trappitsch/cryostorage/cryostorage_controller_2025-09-05.png

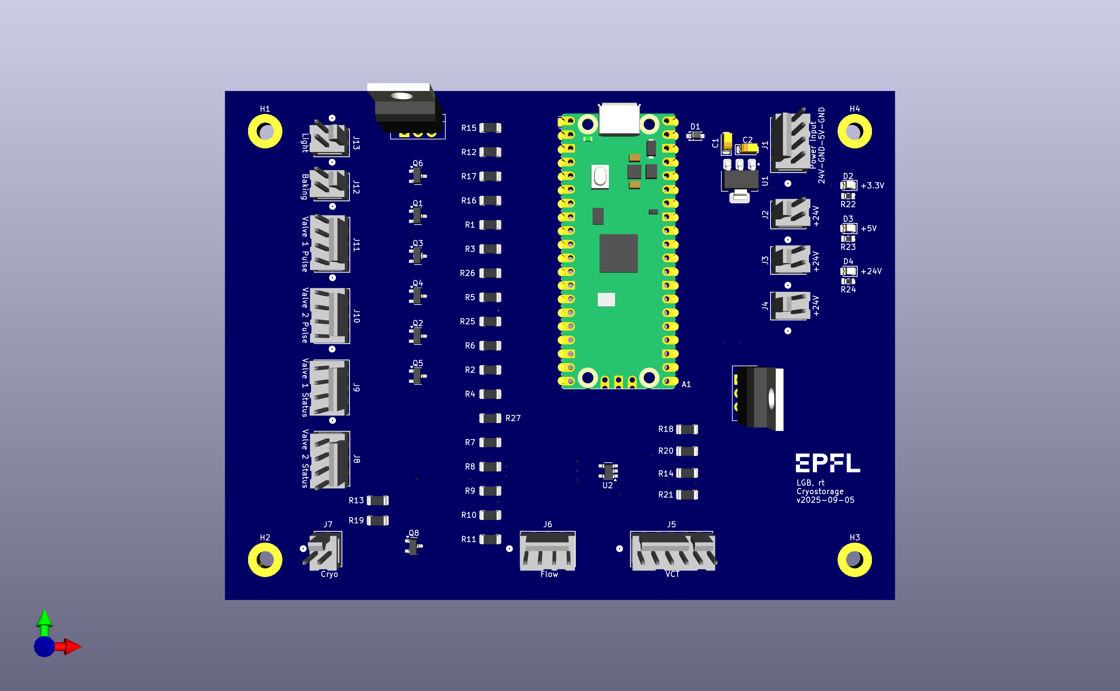
cryostorage_controller_2025-09-05.png
