trappitsch/cryostorage/cryostorage_pcb_2025-09-12.png

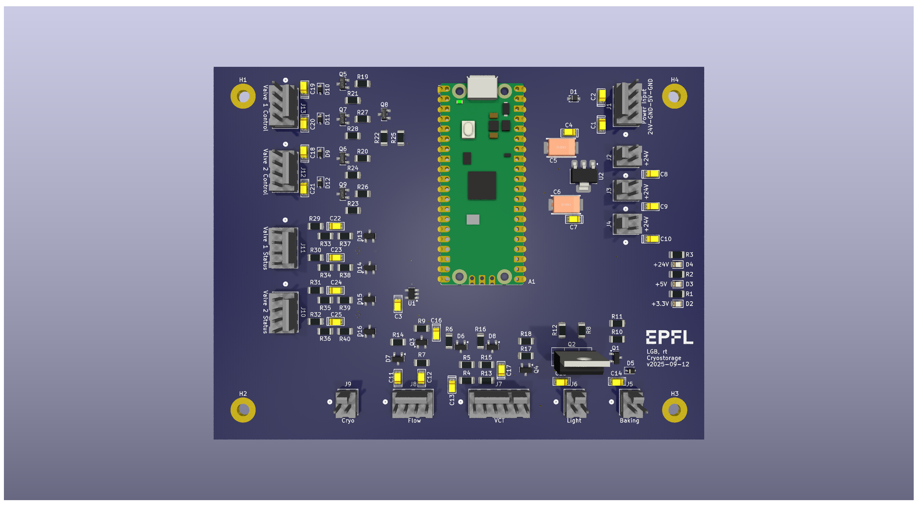
cryostorage_pcb_2025-09-12.png
