trappitsch/cryostorage/controller/pfeiffer_omnicontrol/README.md

# Pfeiffer - Omnicontrol

Instrument driver for the Pfeiffer Omnicontrol.

To run the examples, you can use the following command:

```bash
cargo run --example $NAME
``` 

Here, `$NAME` should be replaced with the name of the example you want to run.
