trappitsch/cryostorage/pcb_controller/.kinotes/cryostorage_controller_v1_worklog_20260212.md

# Work Log — cryostorage_controller_v1
**Total: 0h 0m**
