trappitsch/cryostorage/wiring_schematic_2025-08-26.pdf

A | A
B | B

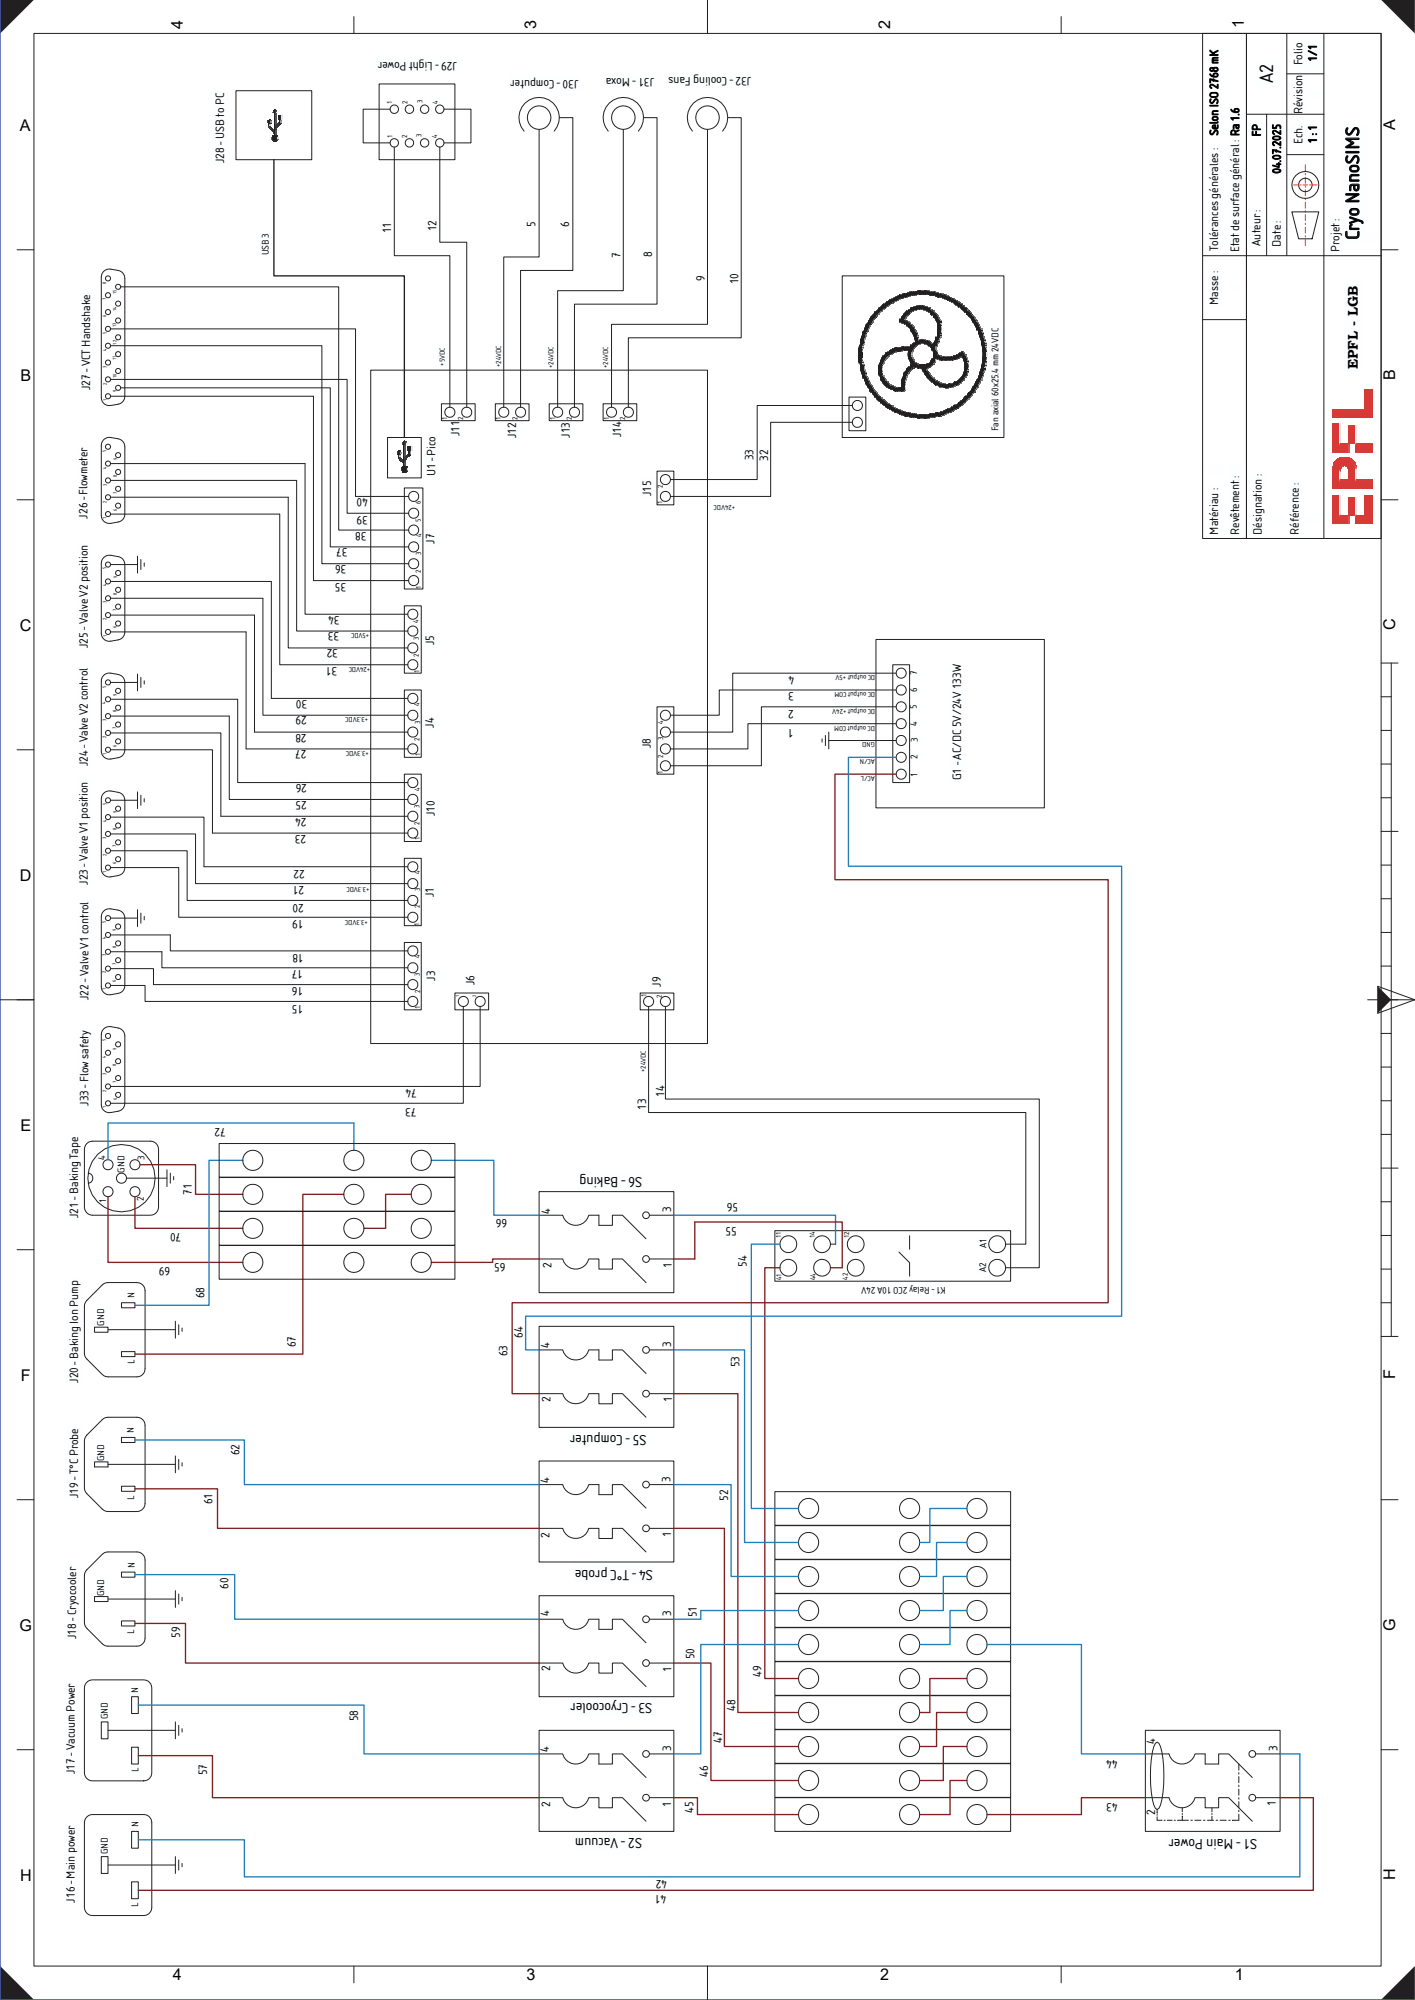
[picture p3: page 1]

Etat de surface général :

J22 - Valve V1 control J23 - Valve V1 position J25 - Valve V2 position J24 - Valve V2 control J26 - Flowmeter

J16 - Main power J17 - Vacuum Power J18 - Cryocooler J19 - T°C Probe J20 - Baking Ion Pump J21 - Baking Tape

GND GND GND GND GND
