trappitsch/cryostorage/cryostorage_schematic_2026-07-10.pdf

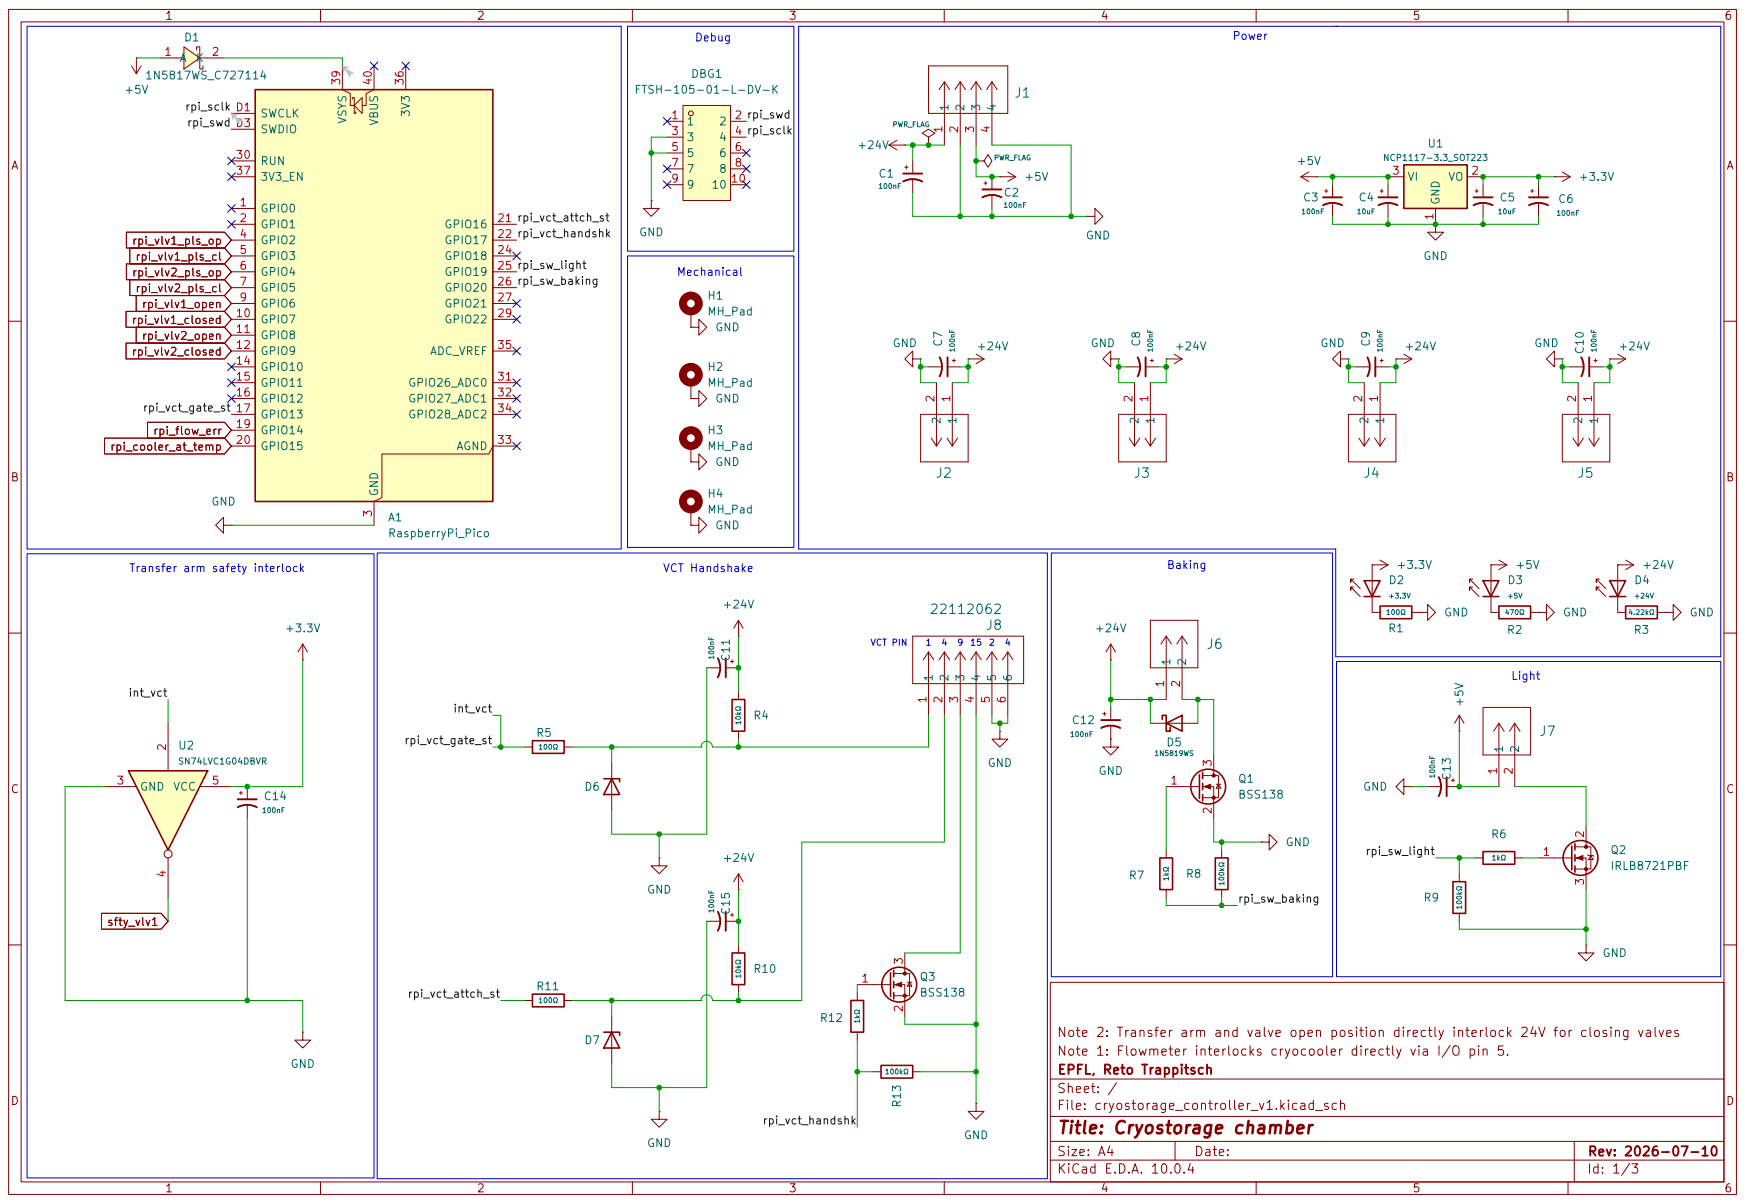
[picture p4: page 1]

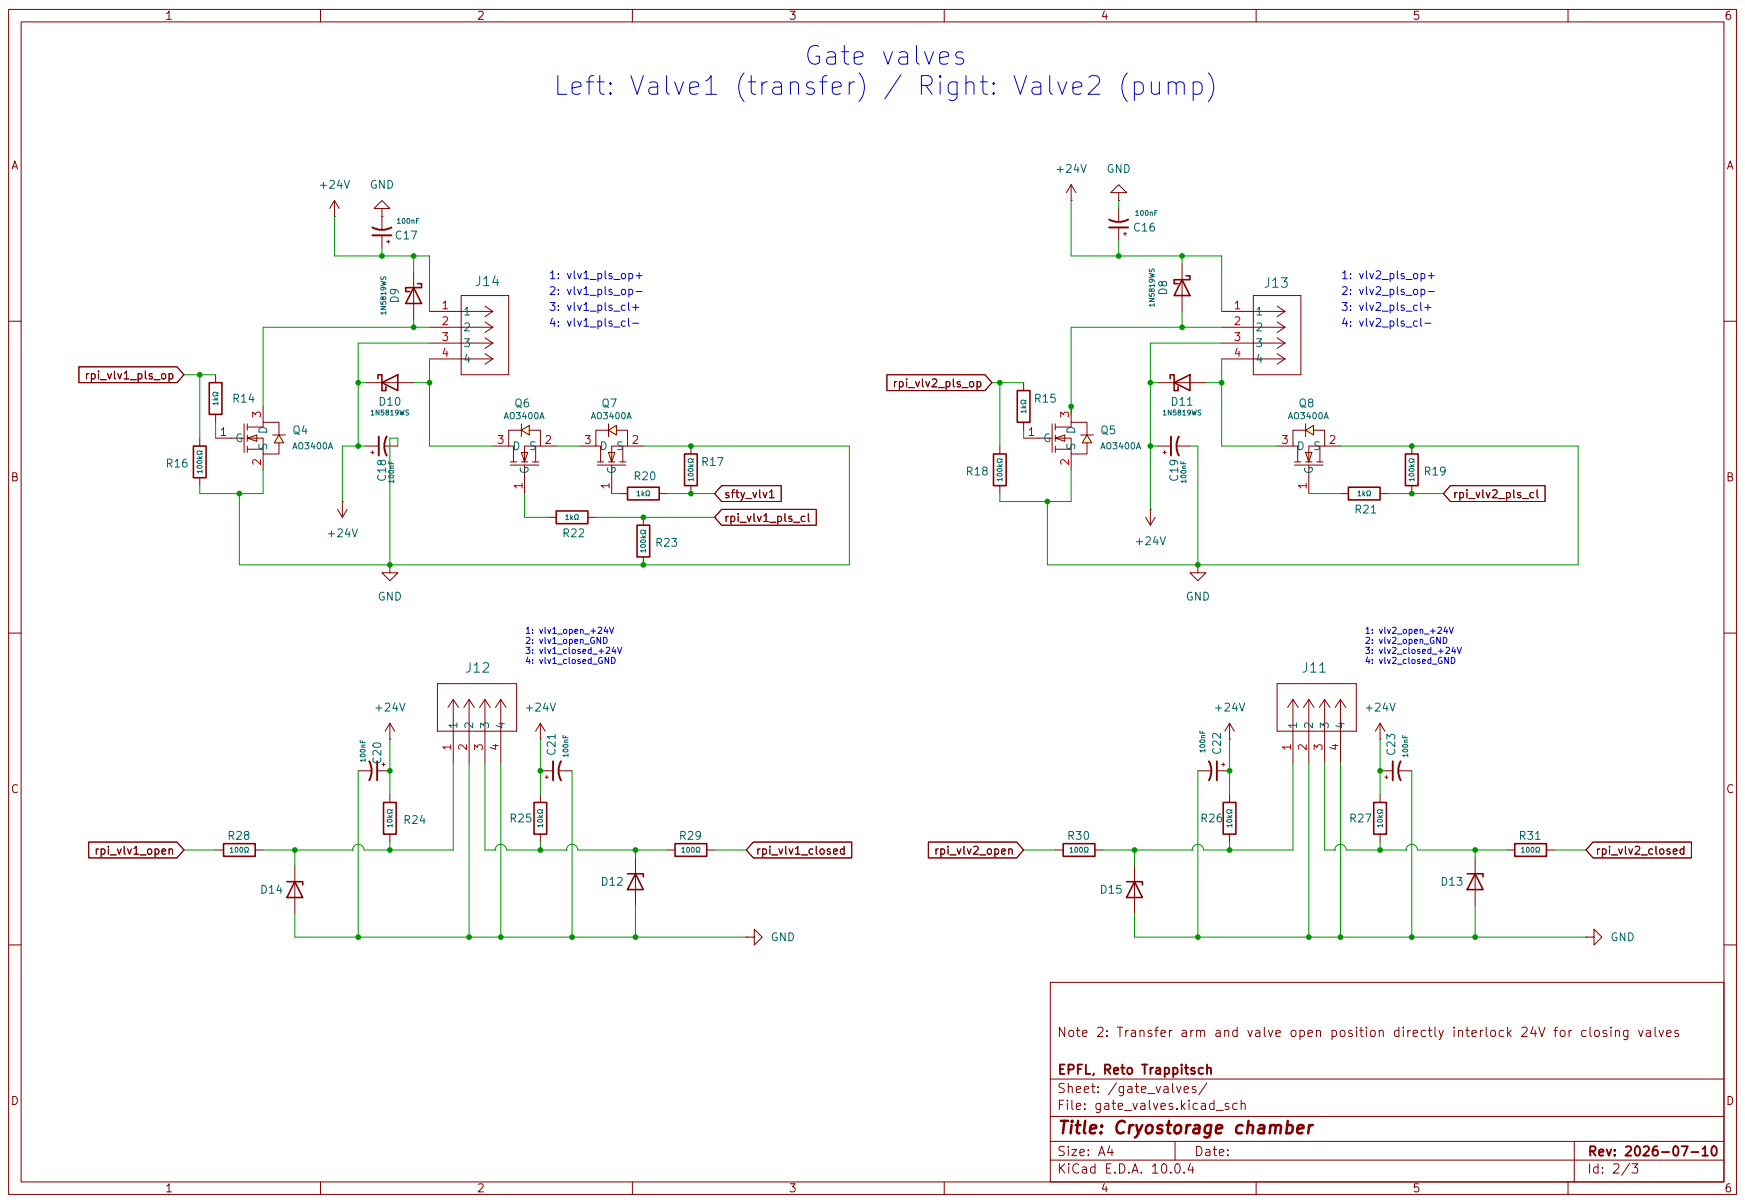
[picture p5: page 2]

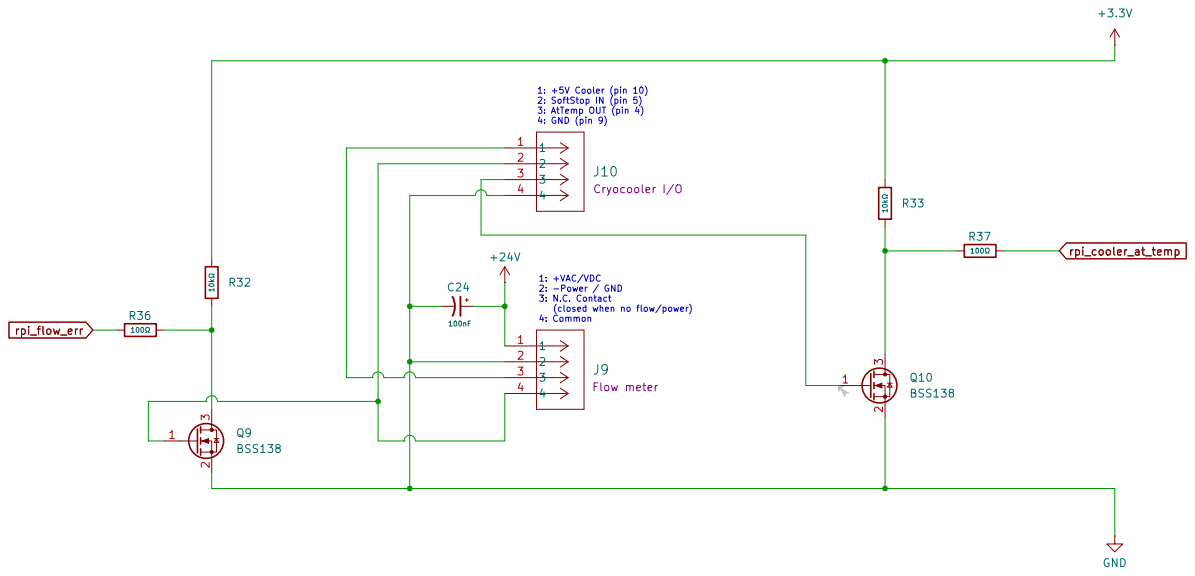
[picture p6: page 3]
