trappitsch/cryostorage/cryostorage_schematic_2026-02-13.pdf

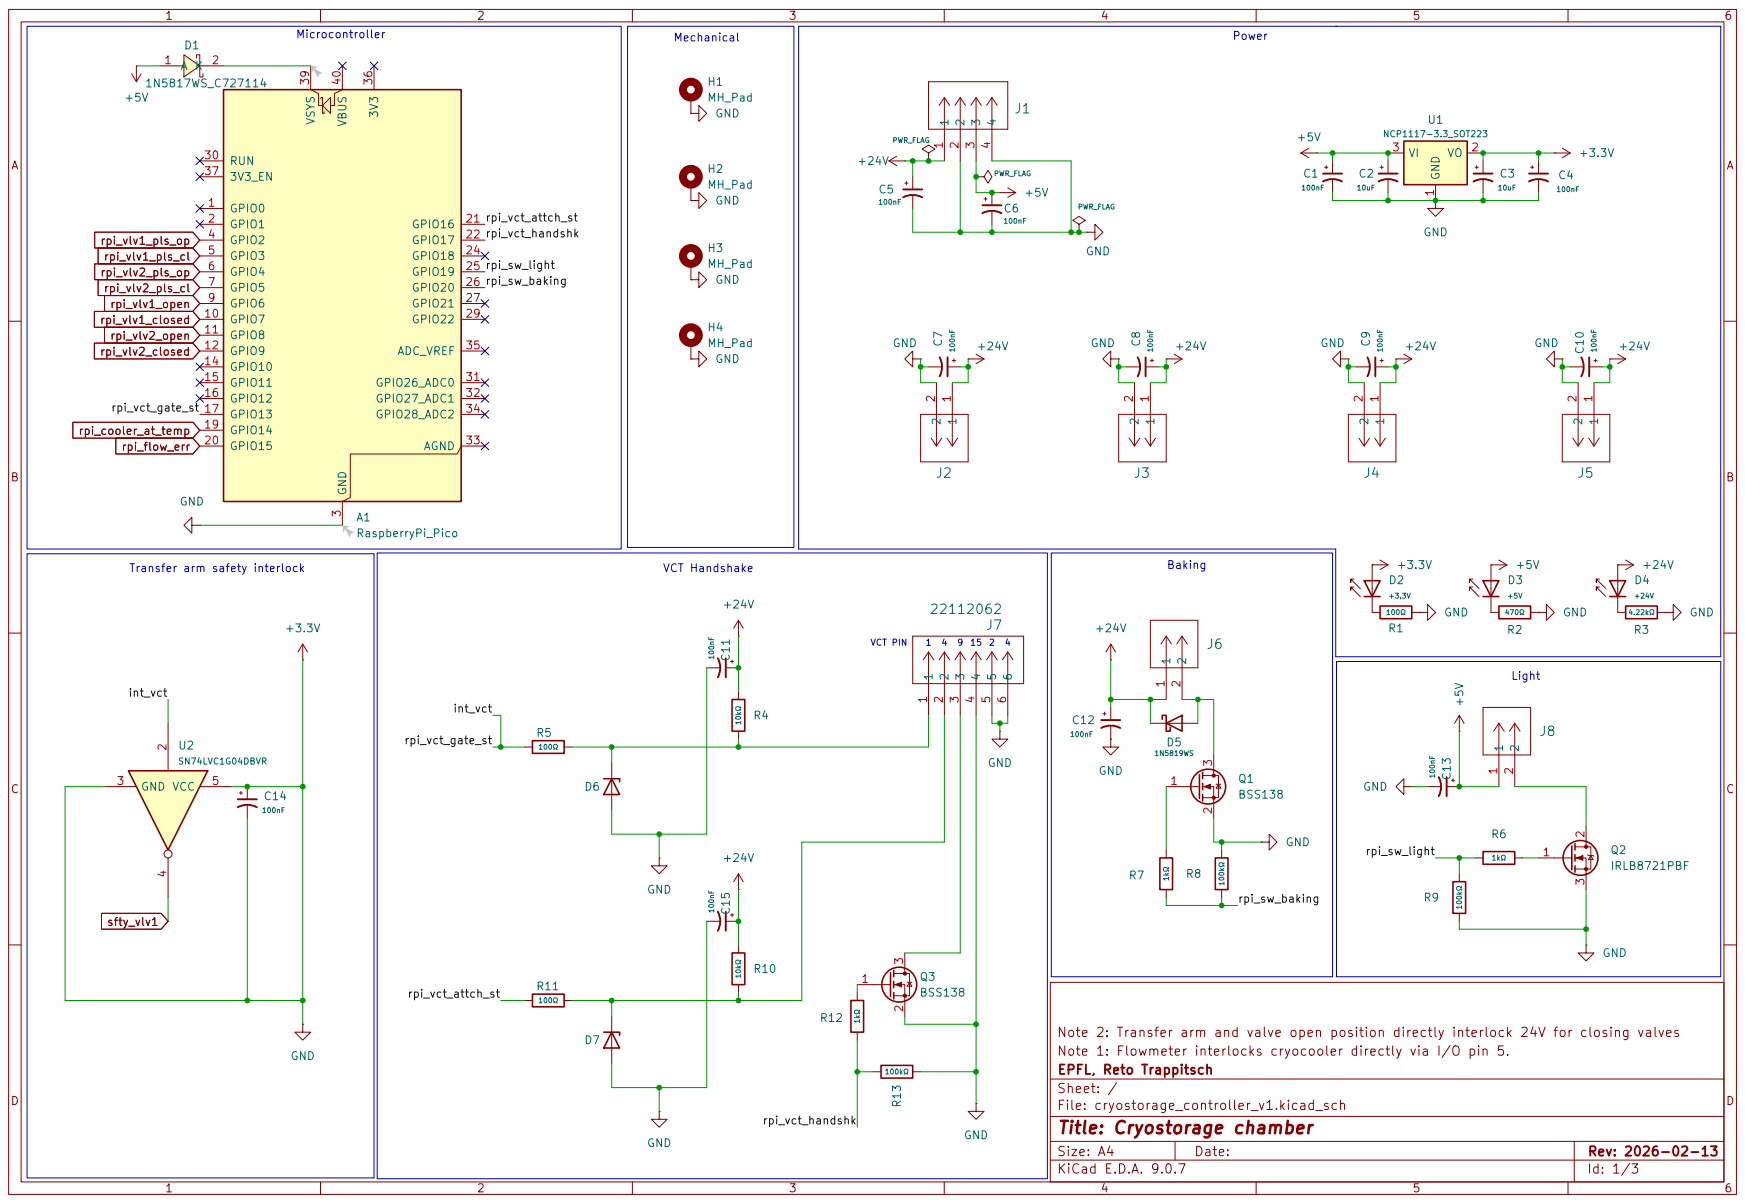
[picture p10: page 1]

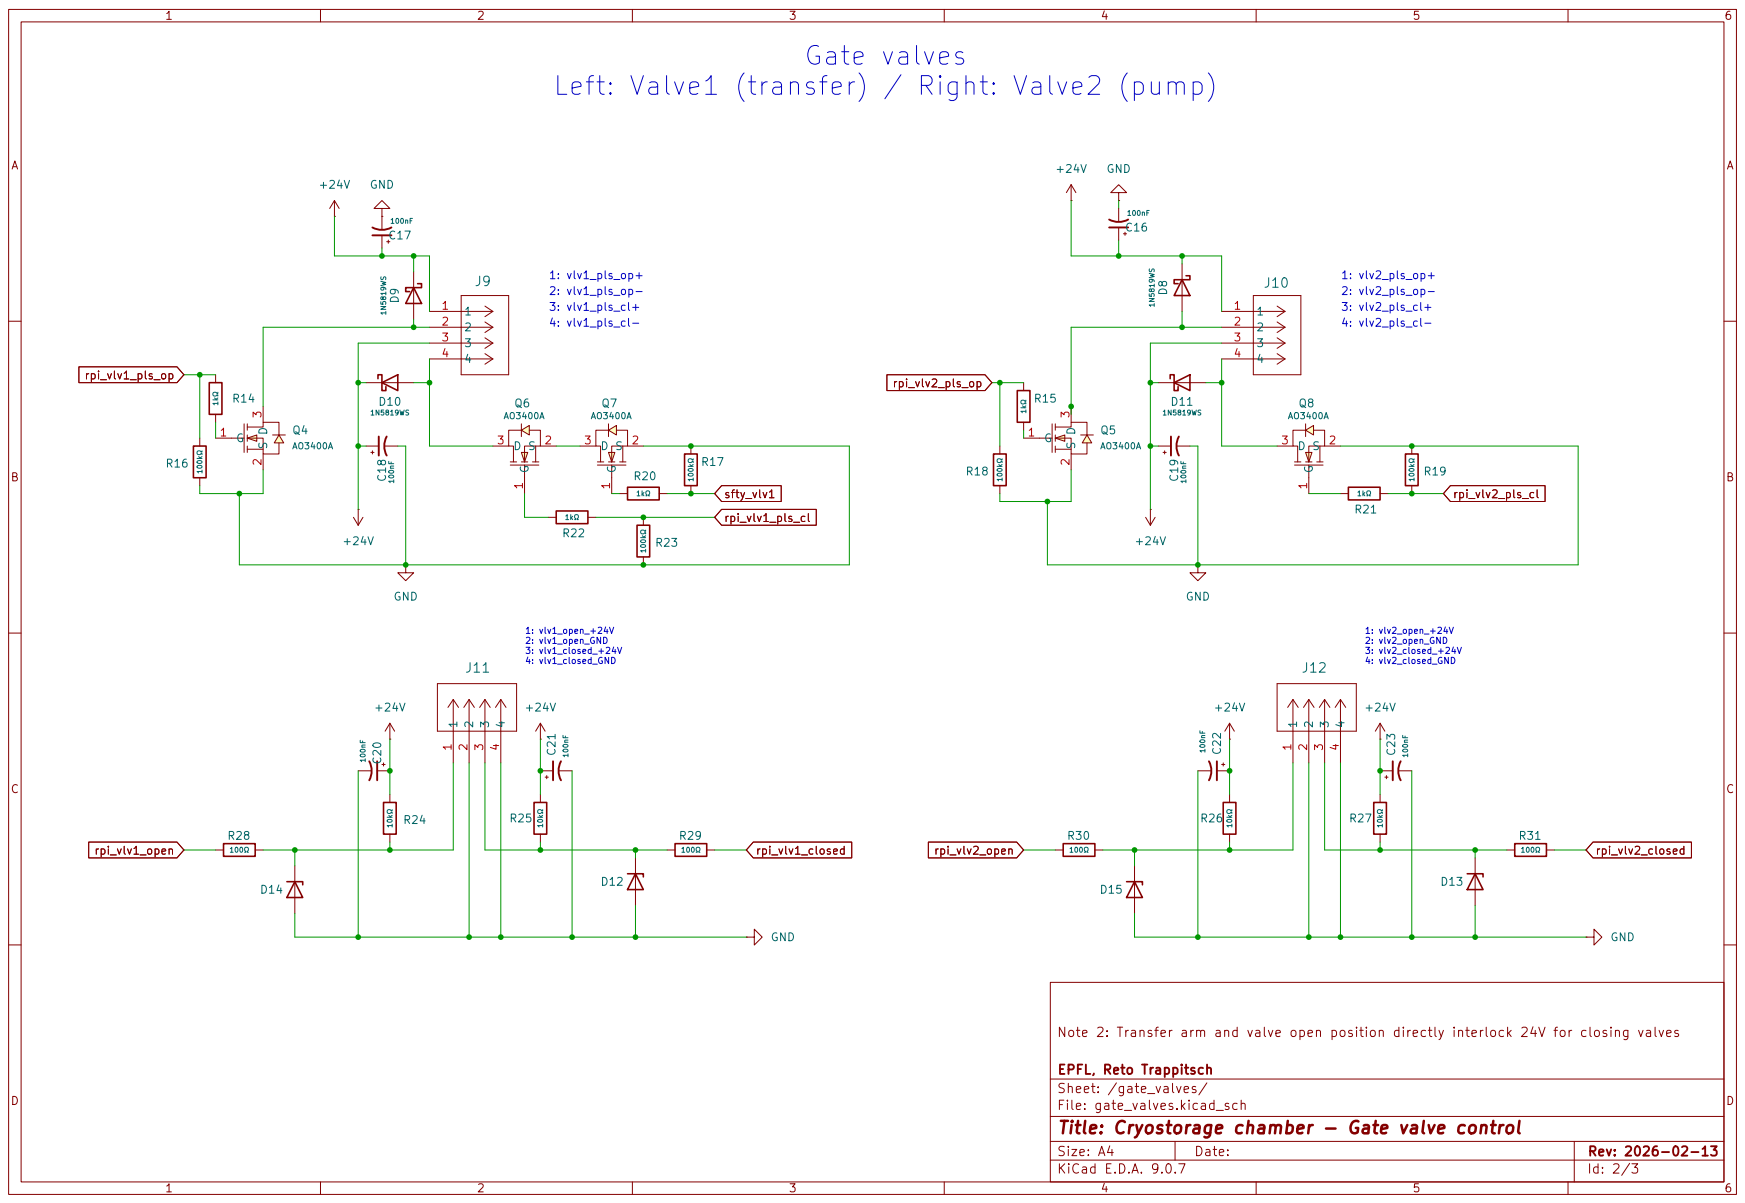
[picture p11: page 2]

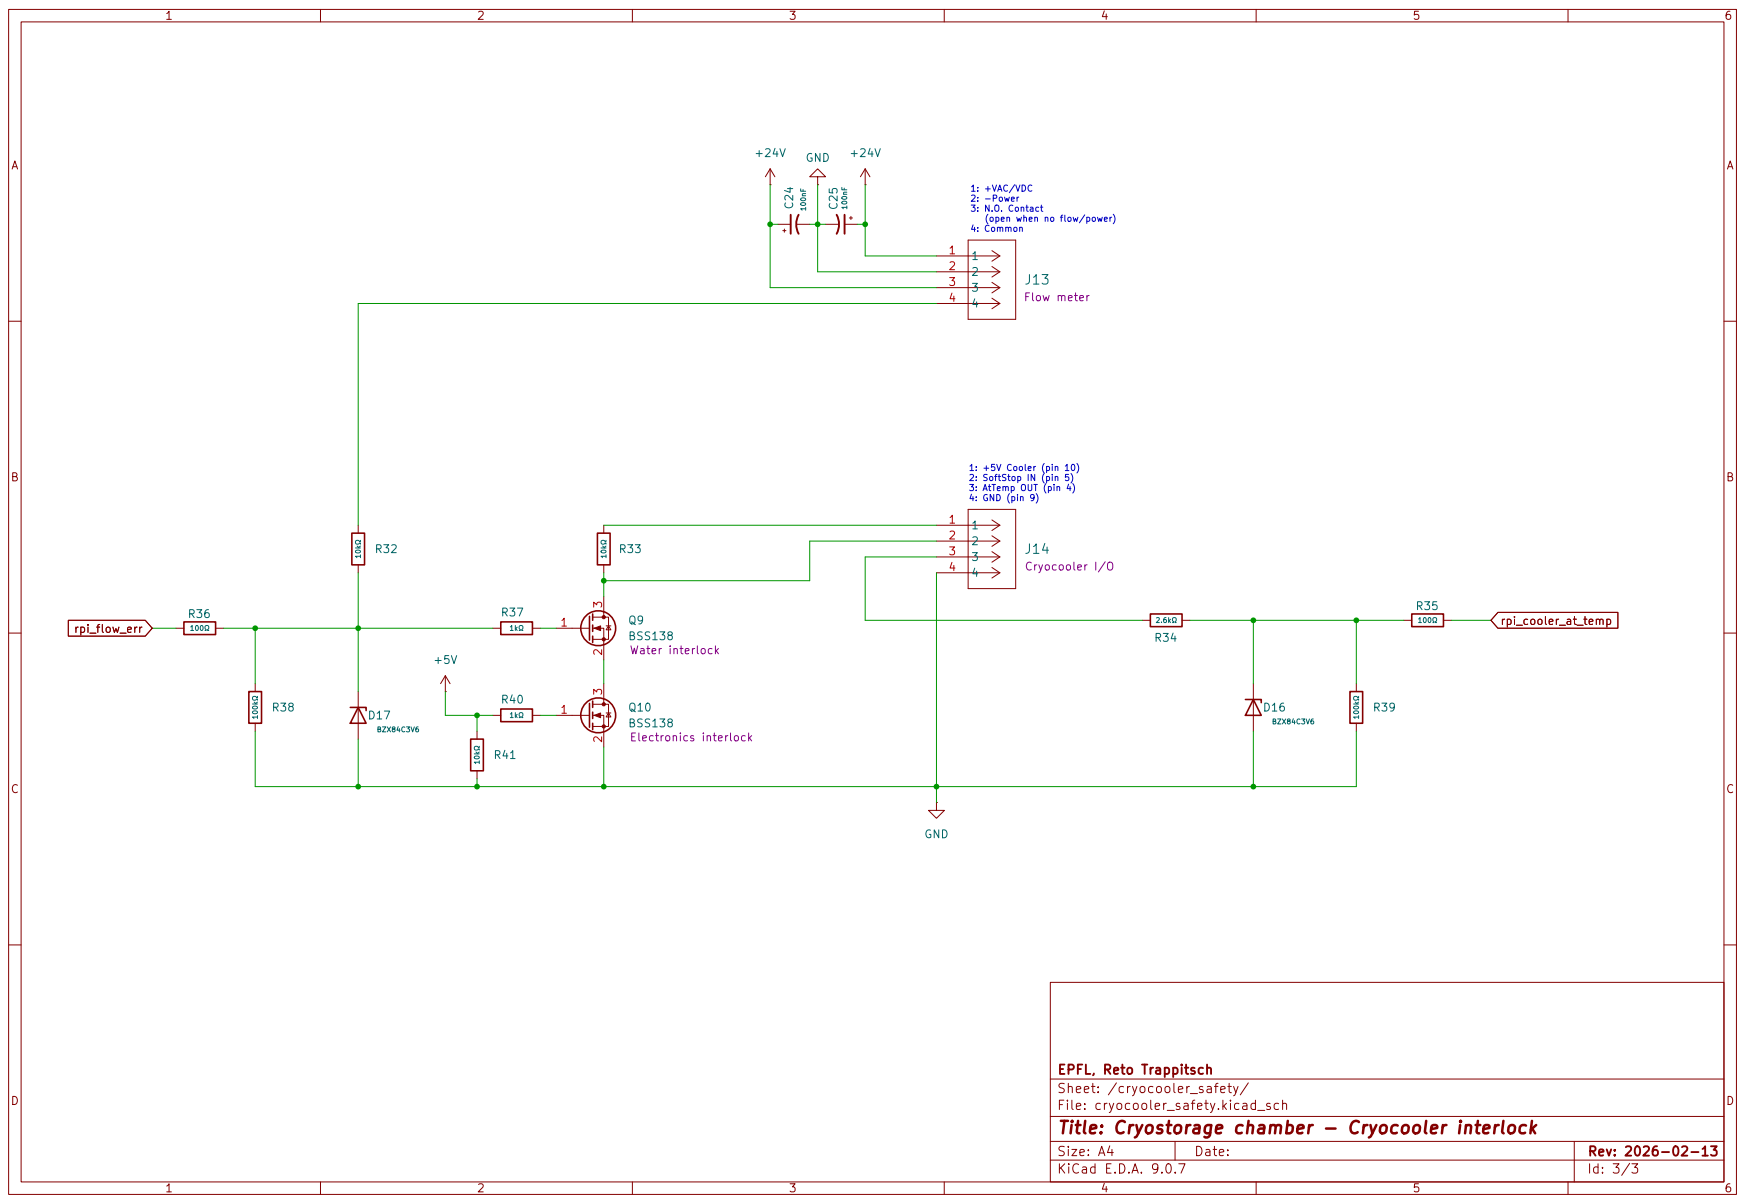
[picture p12: page 3]
