trappitsch/cryostorage/cryostorage_pcb_2025-09-23.pdf

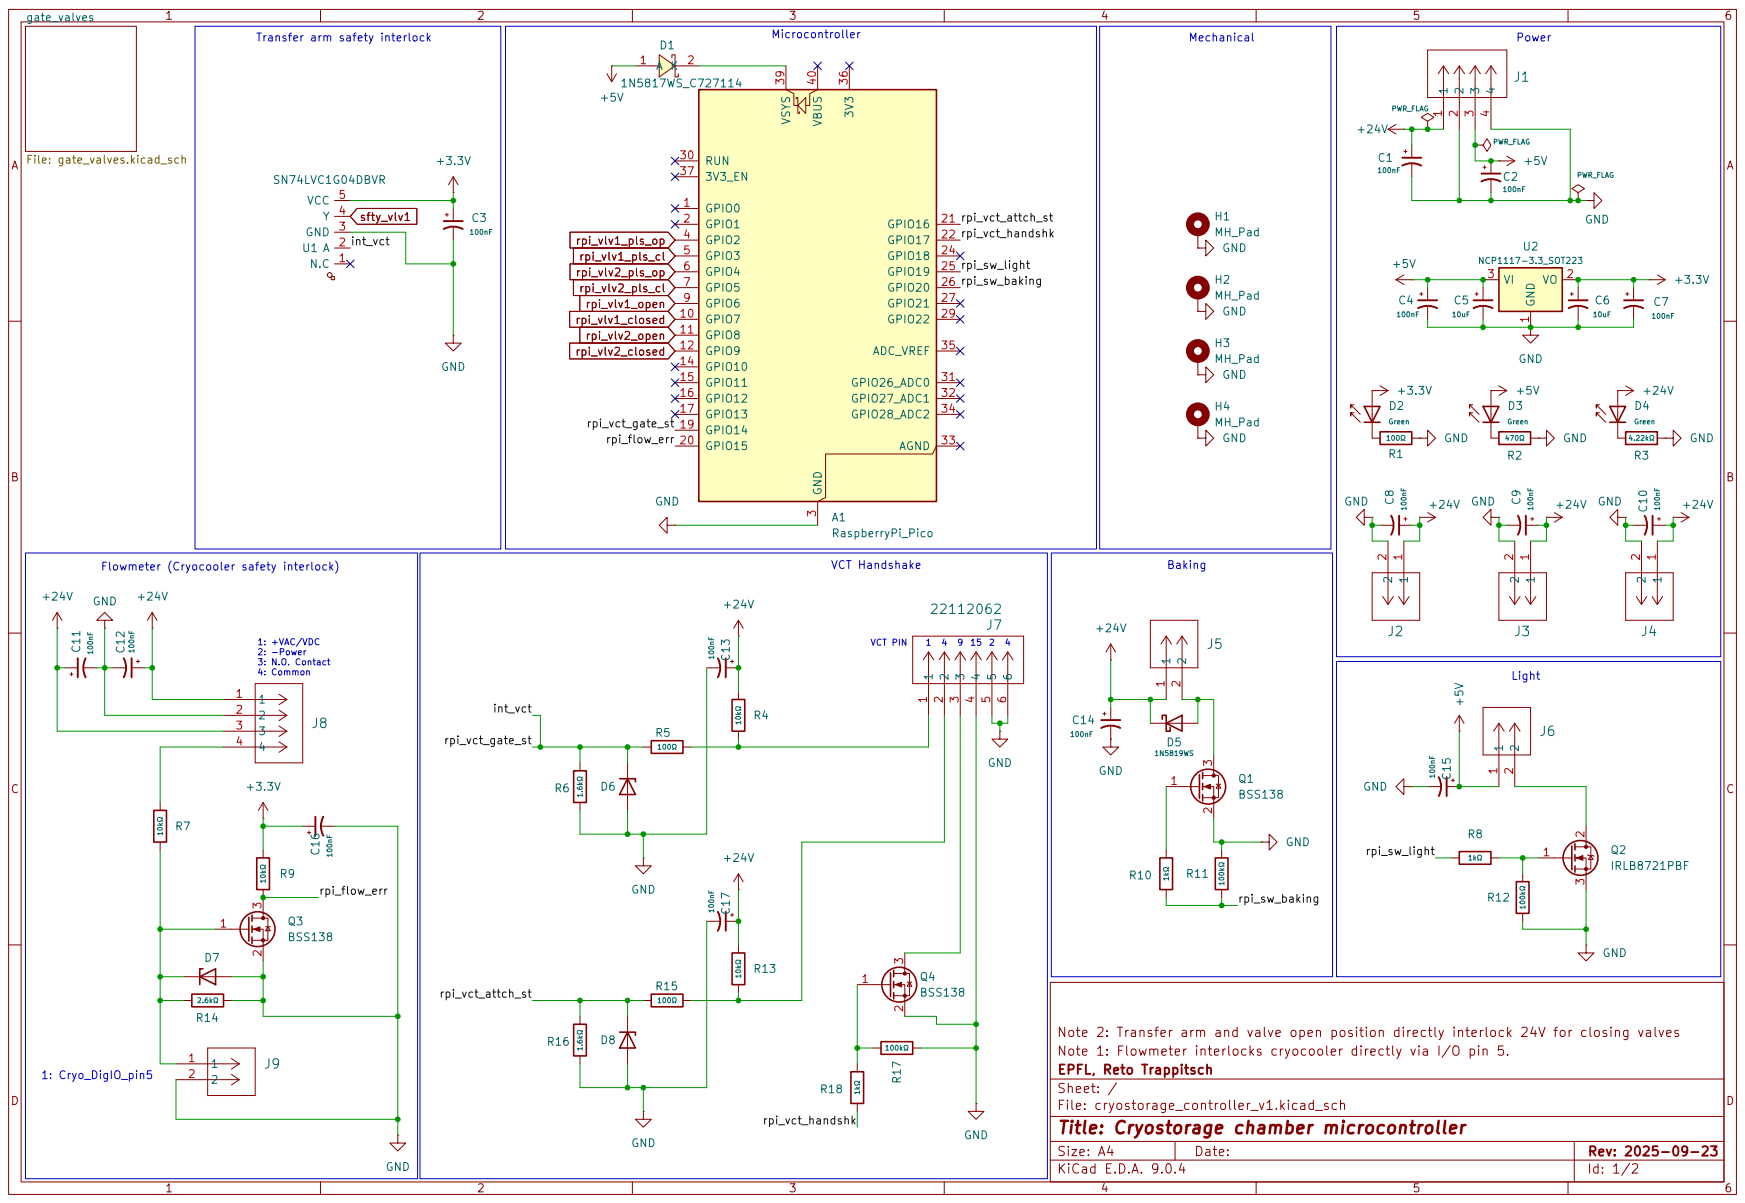
[picture p13: page 1]

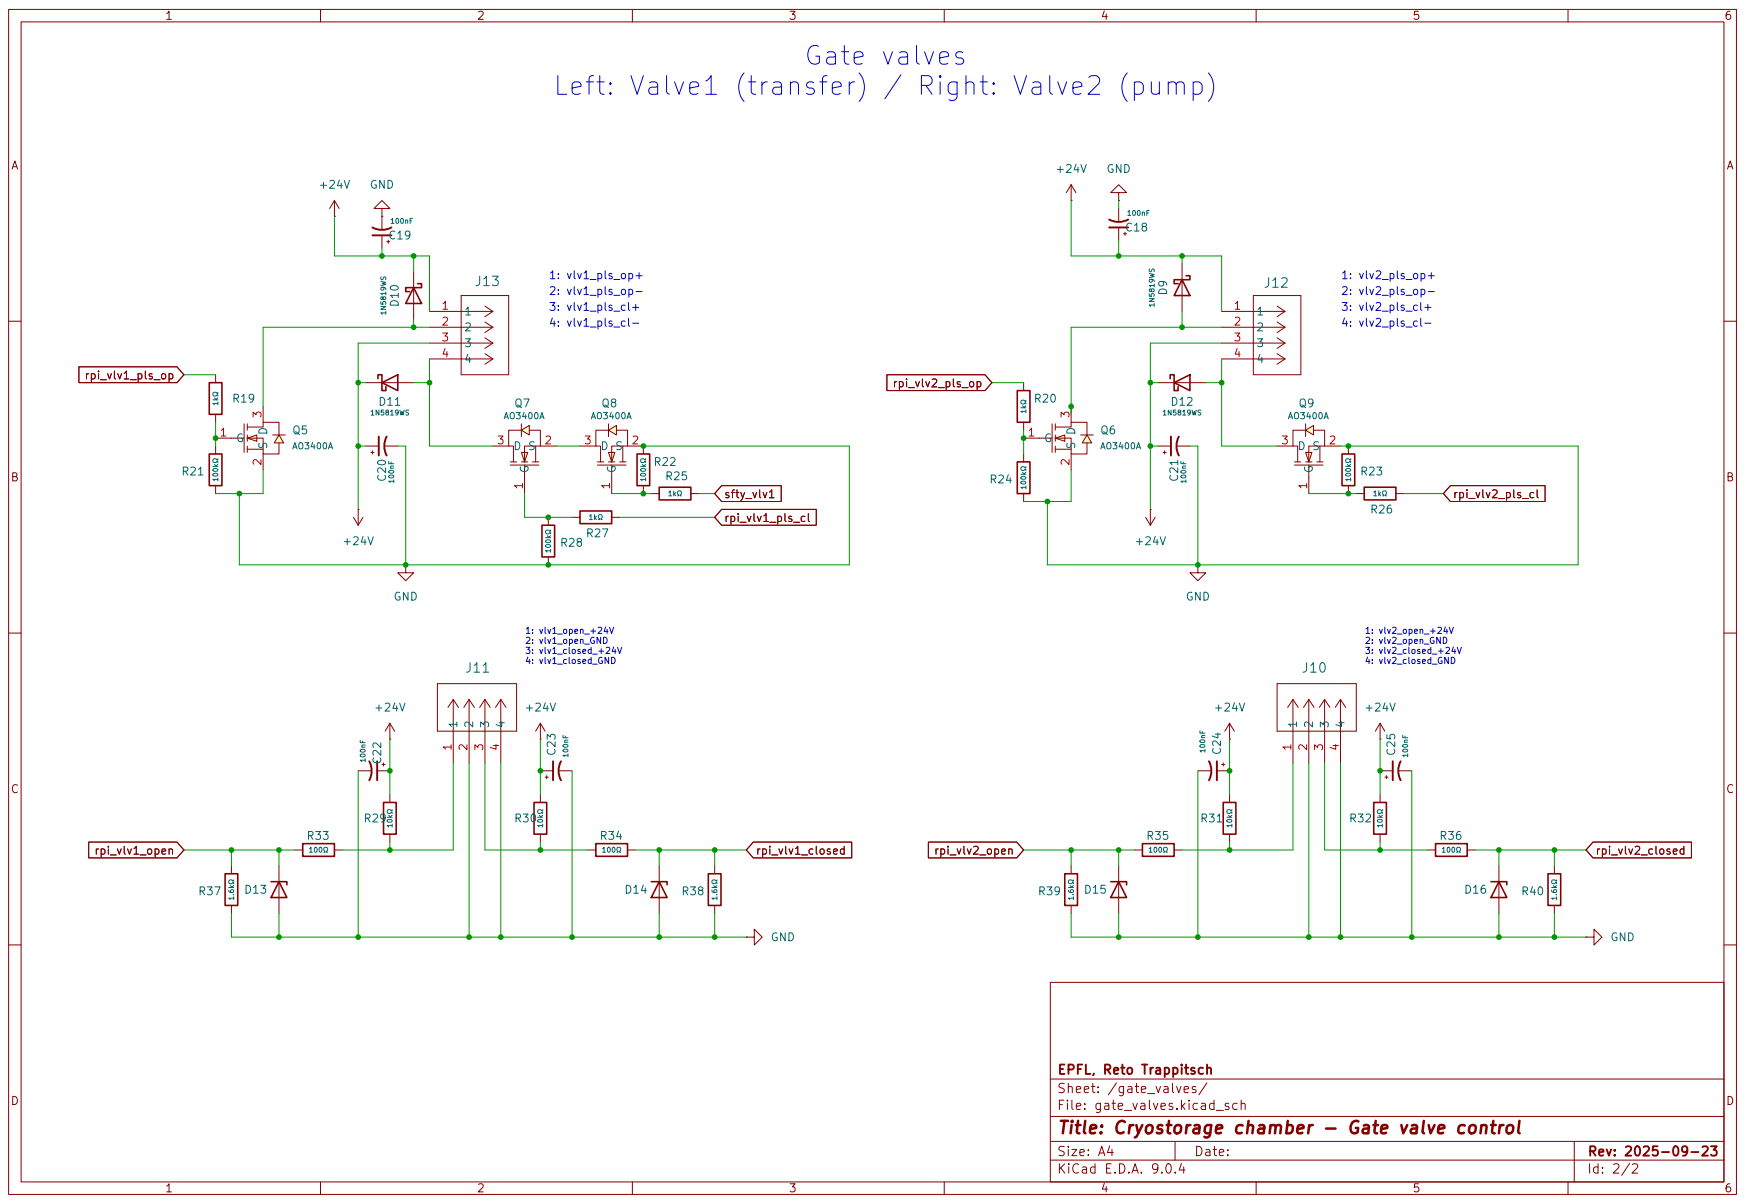
[picture p14: page 2]
