trappitsch/cryostorage/cryostorage_pcb_2025-09-10.pdf

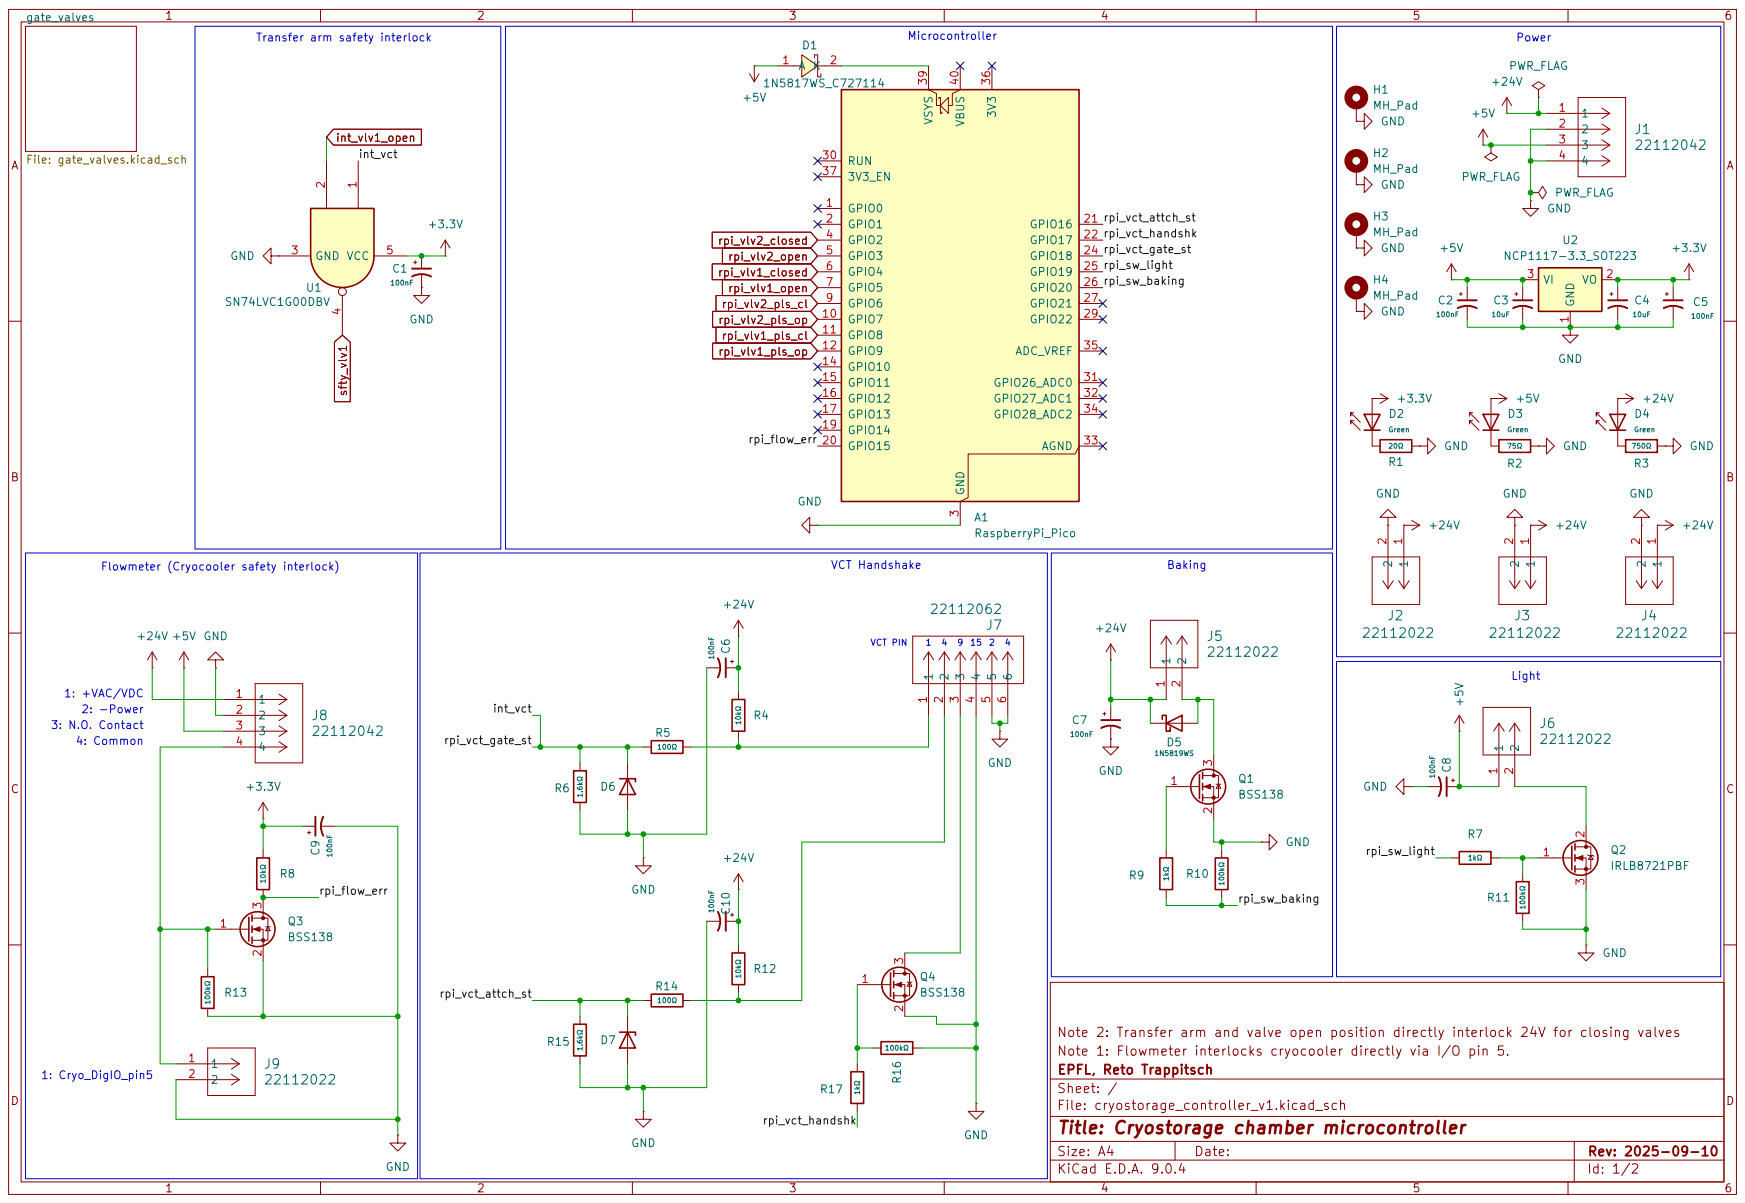
[picture p15: page 1]

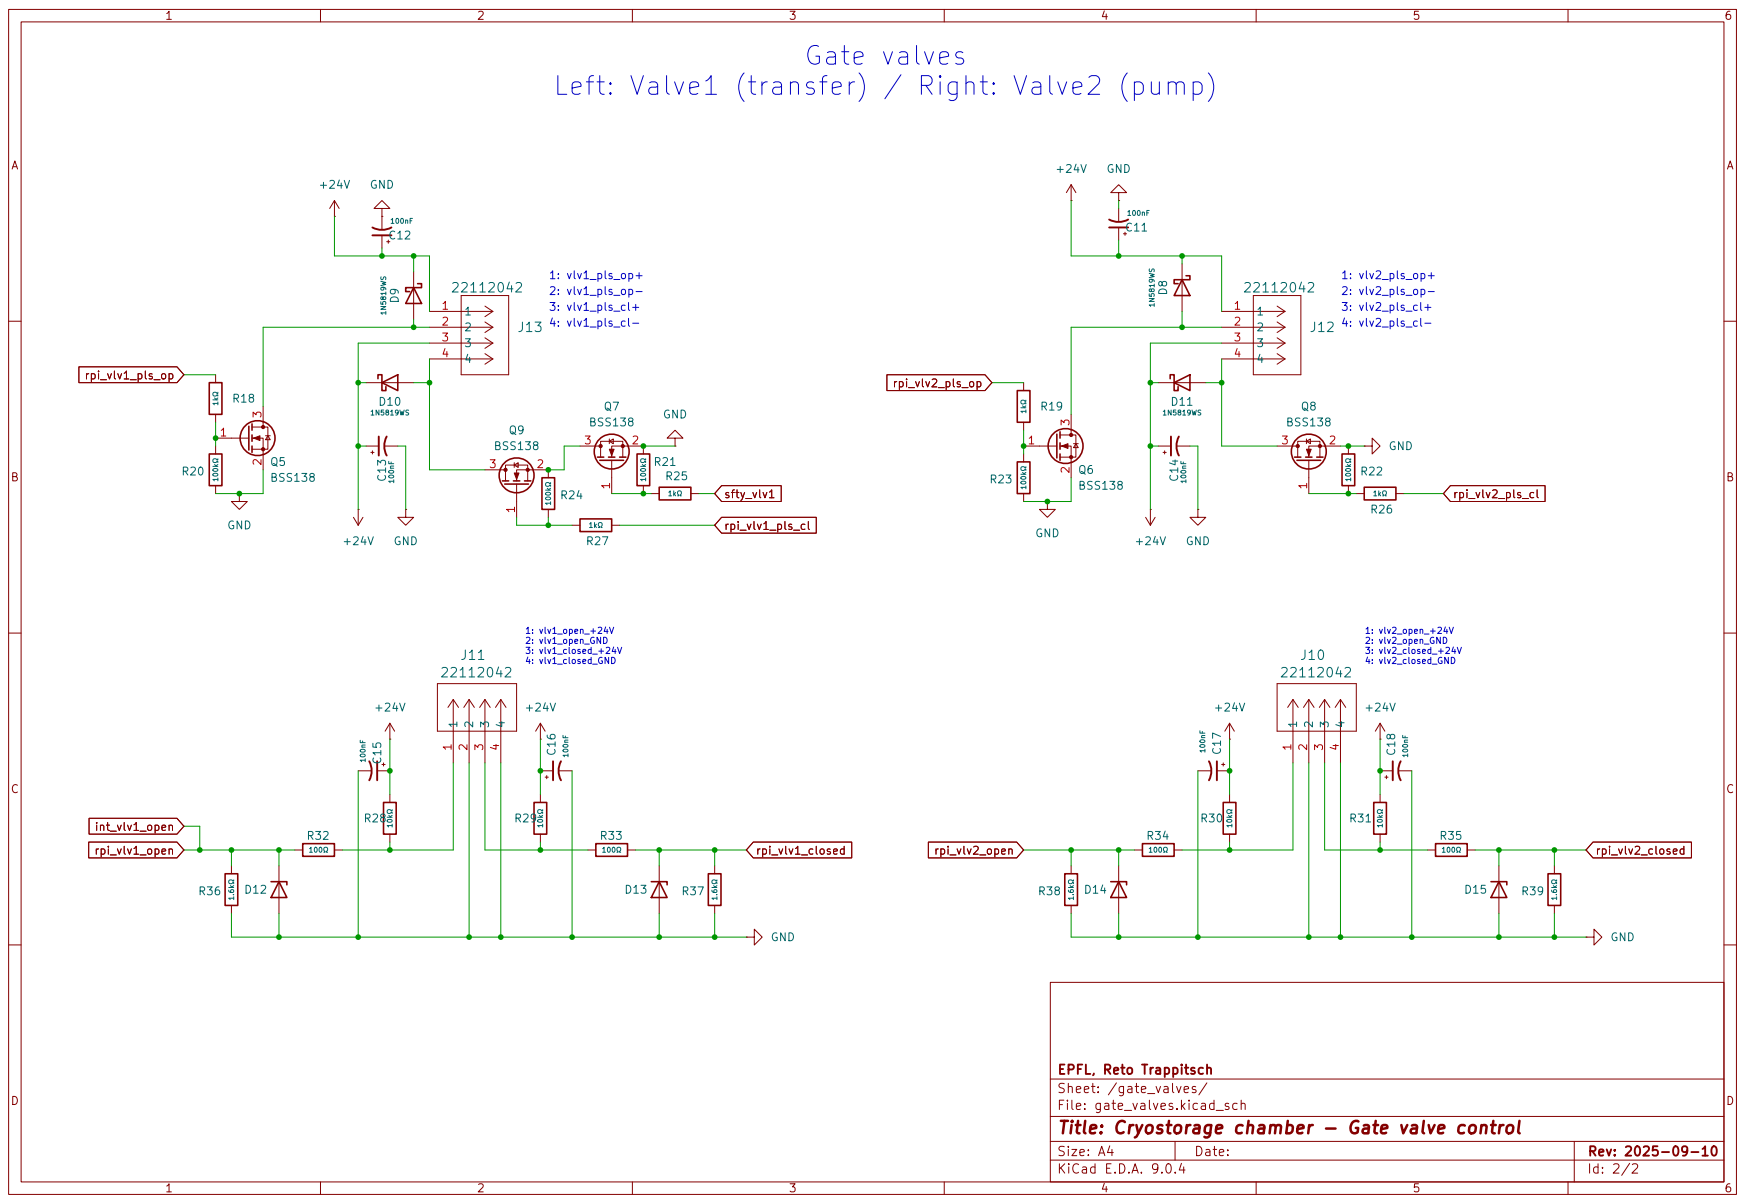
[picture p16: page 2]
