trappitsch/cryostorage/cryostorage_pcb_2025-09-12.pdf

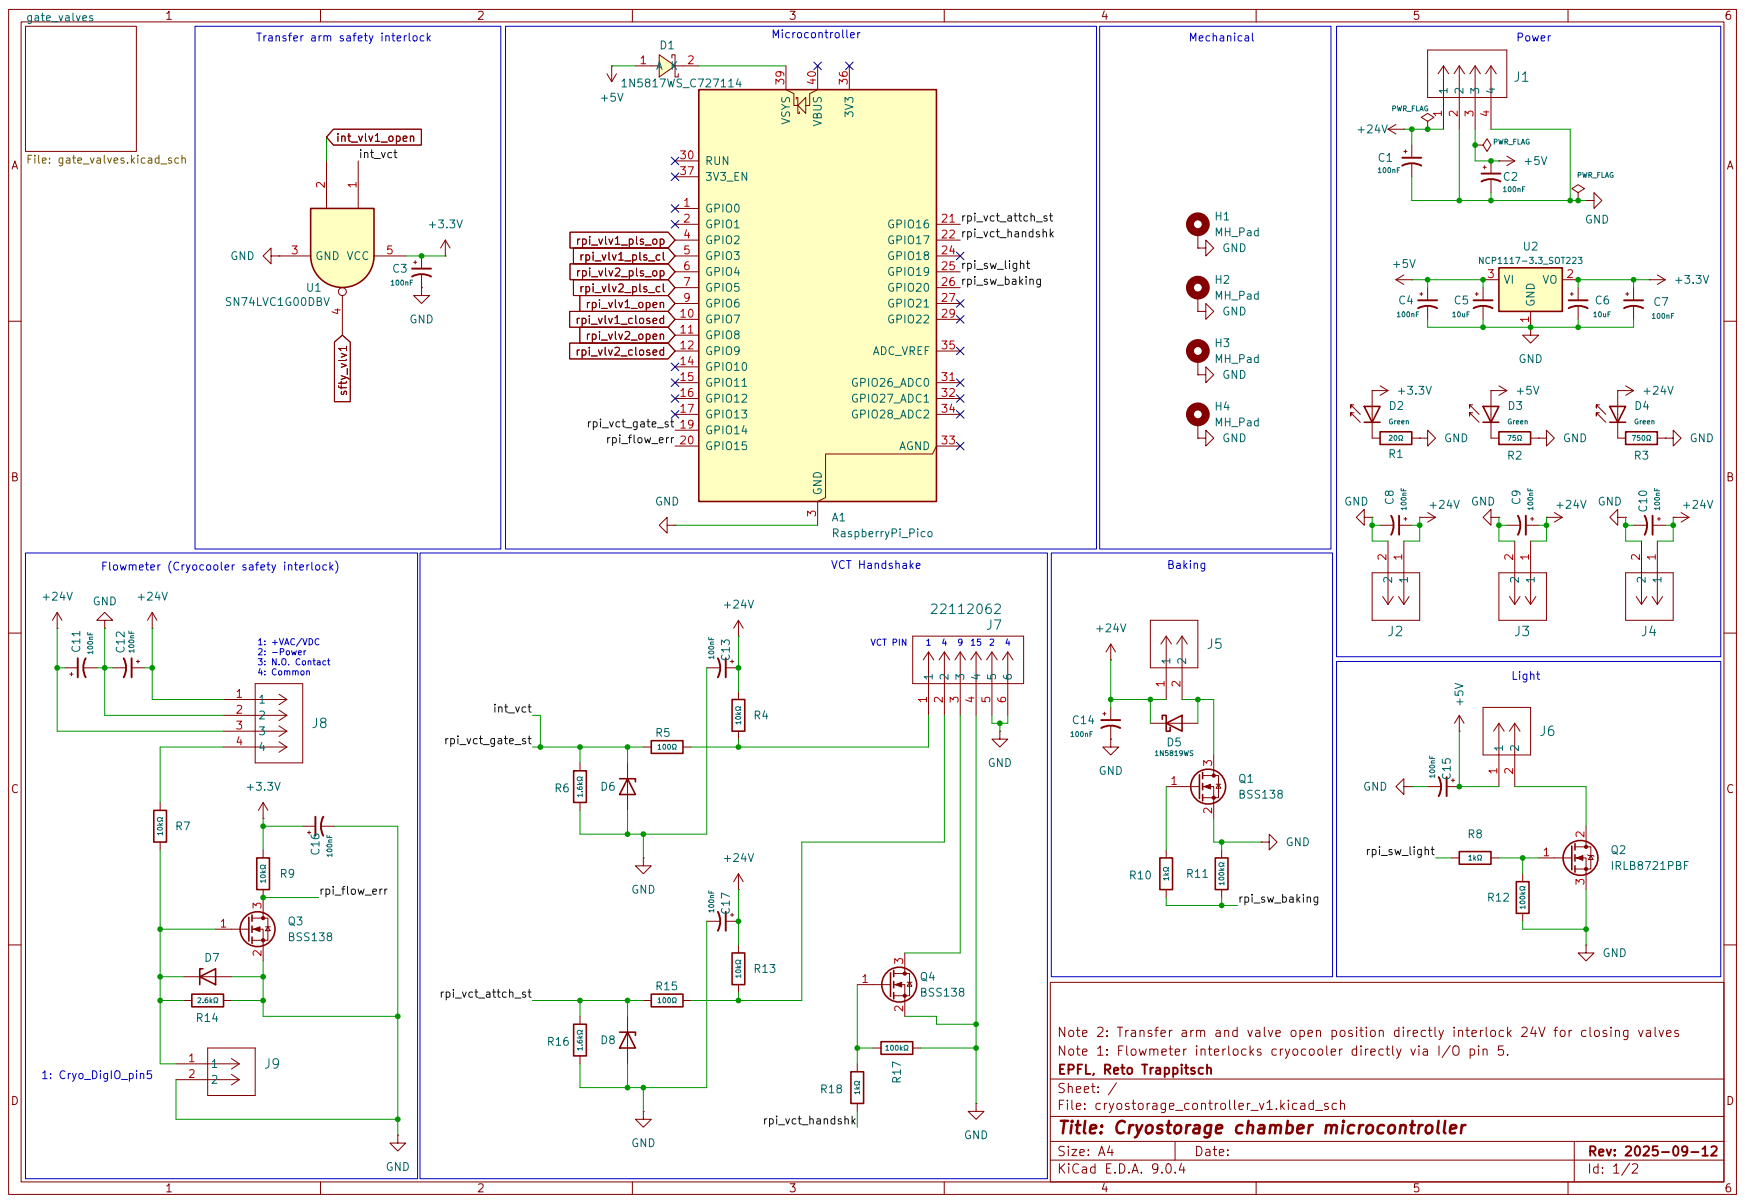
[picture p17: page 1]

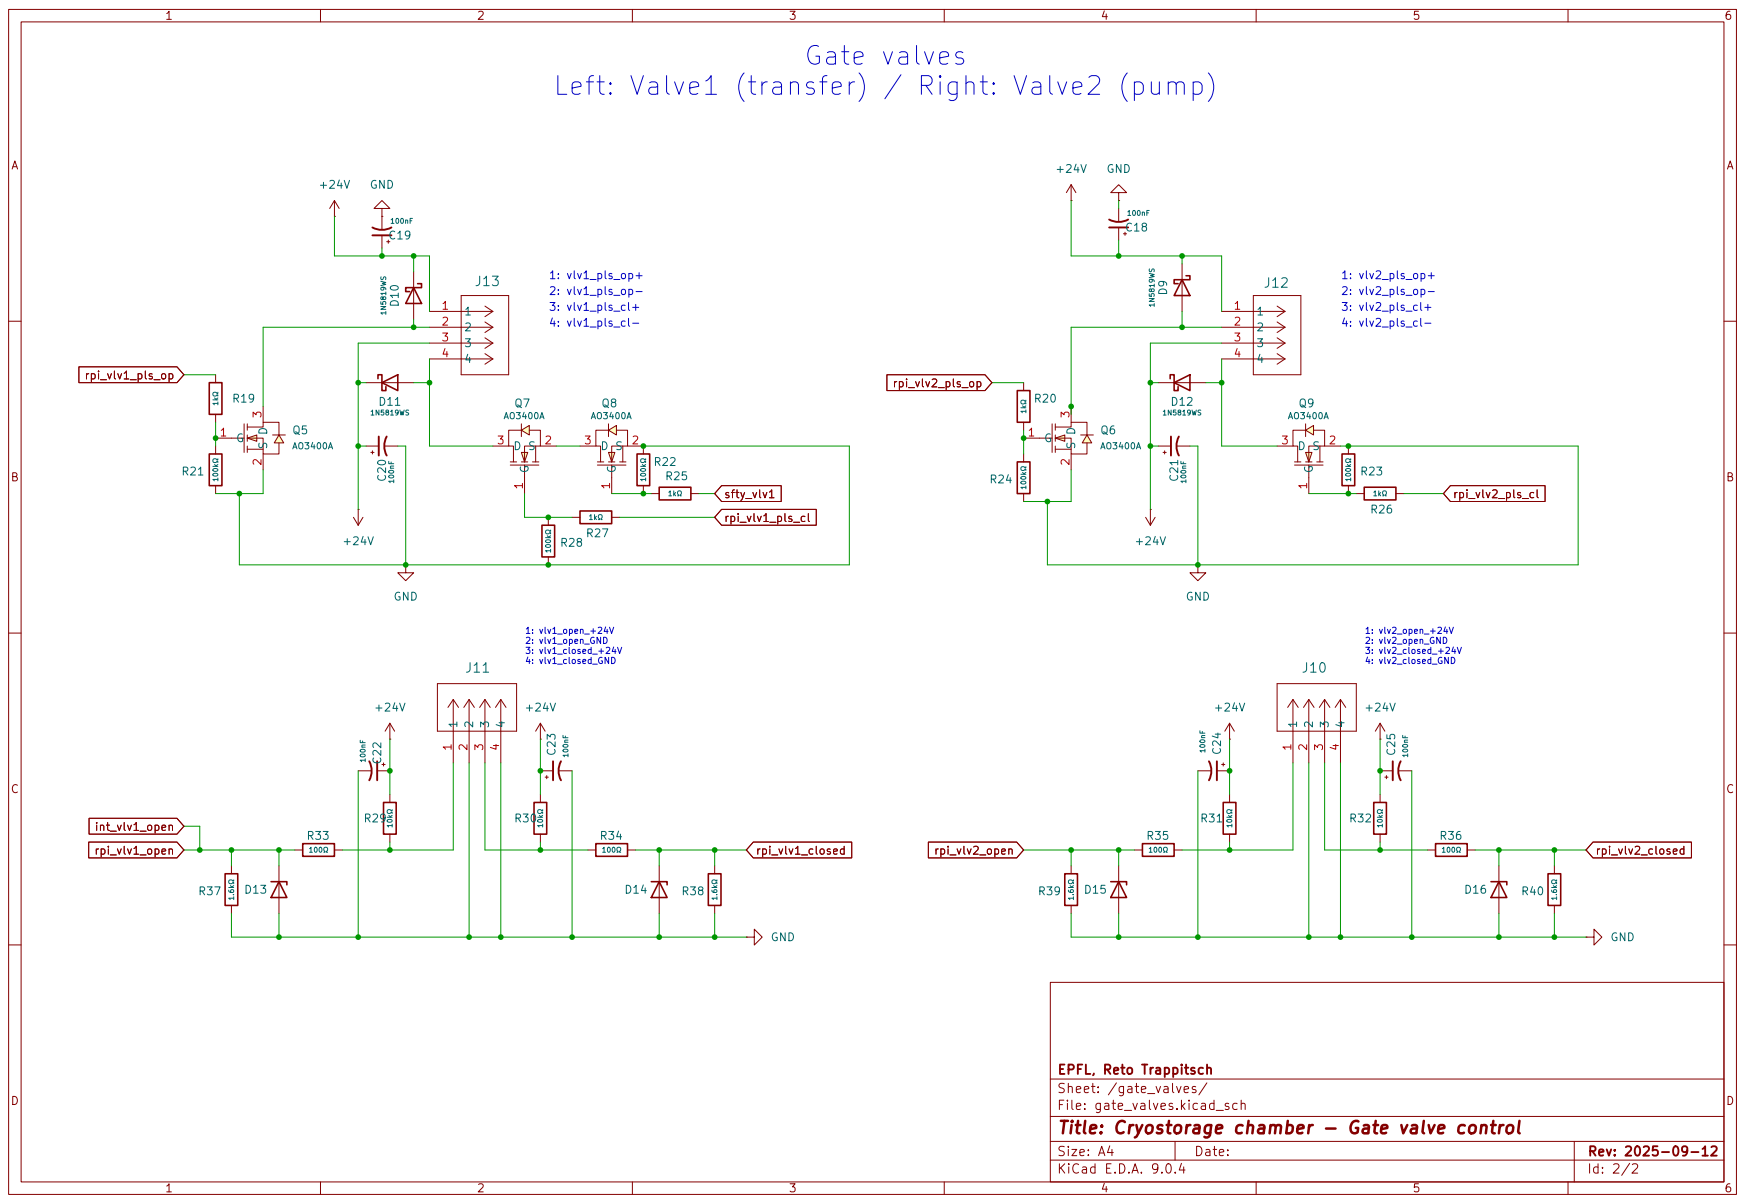
[picture p18: page 2]
