trappitsch/cryostorage/cryostorage_pcb_2025-09-05.pdf

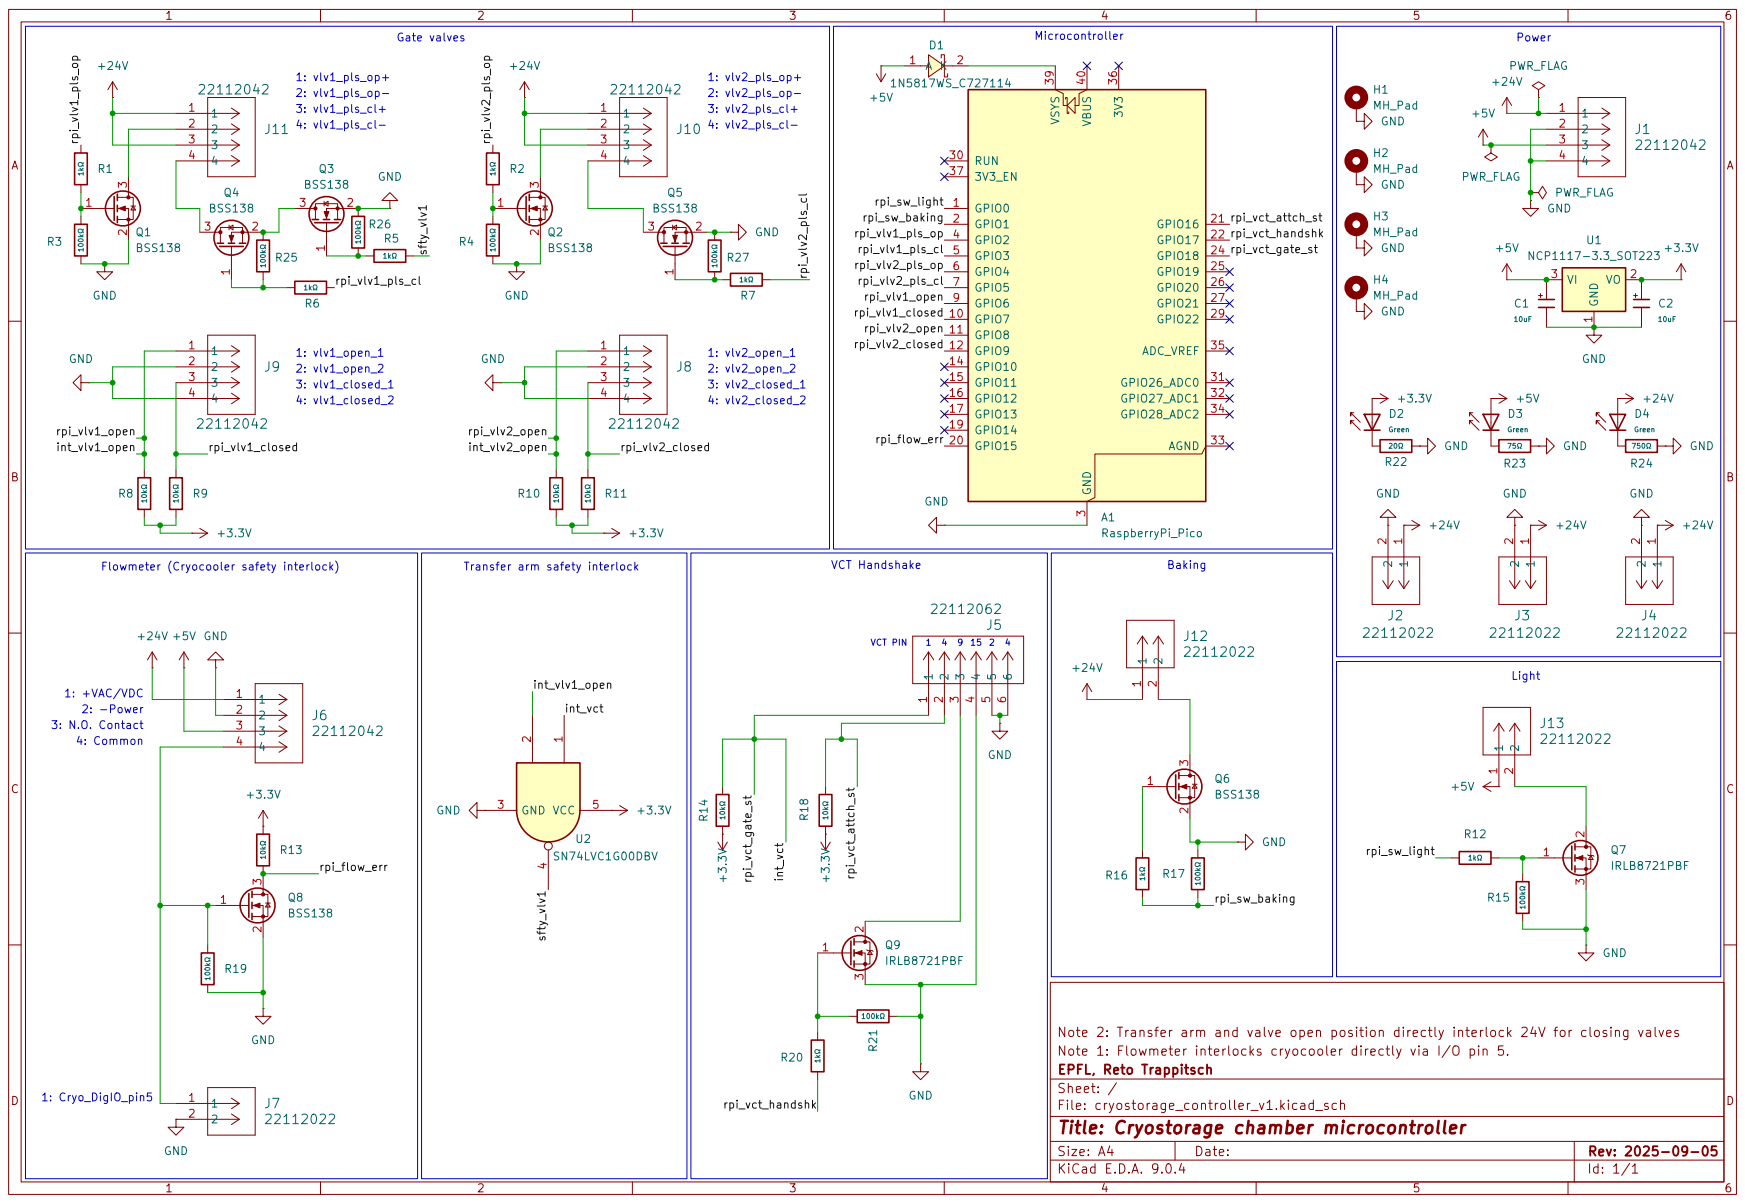
[picture p19: page 1]
