trappitsch/cryostorage/cryostorage_pcb_2025-08-26.pdf

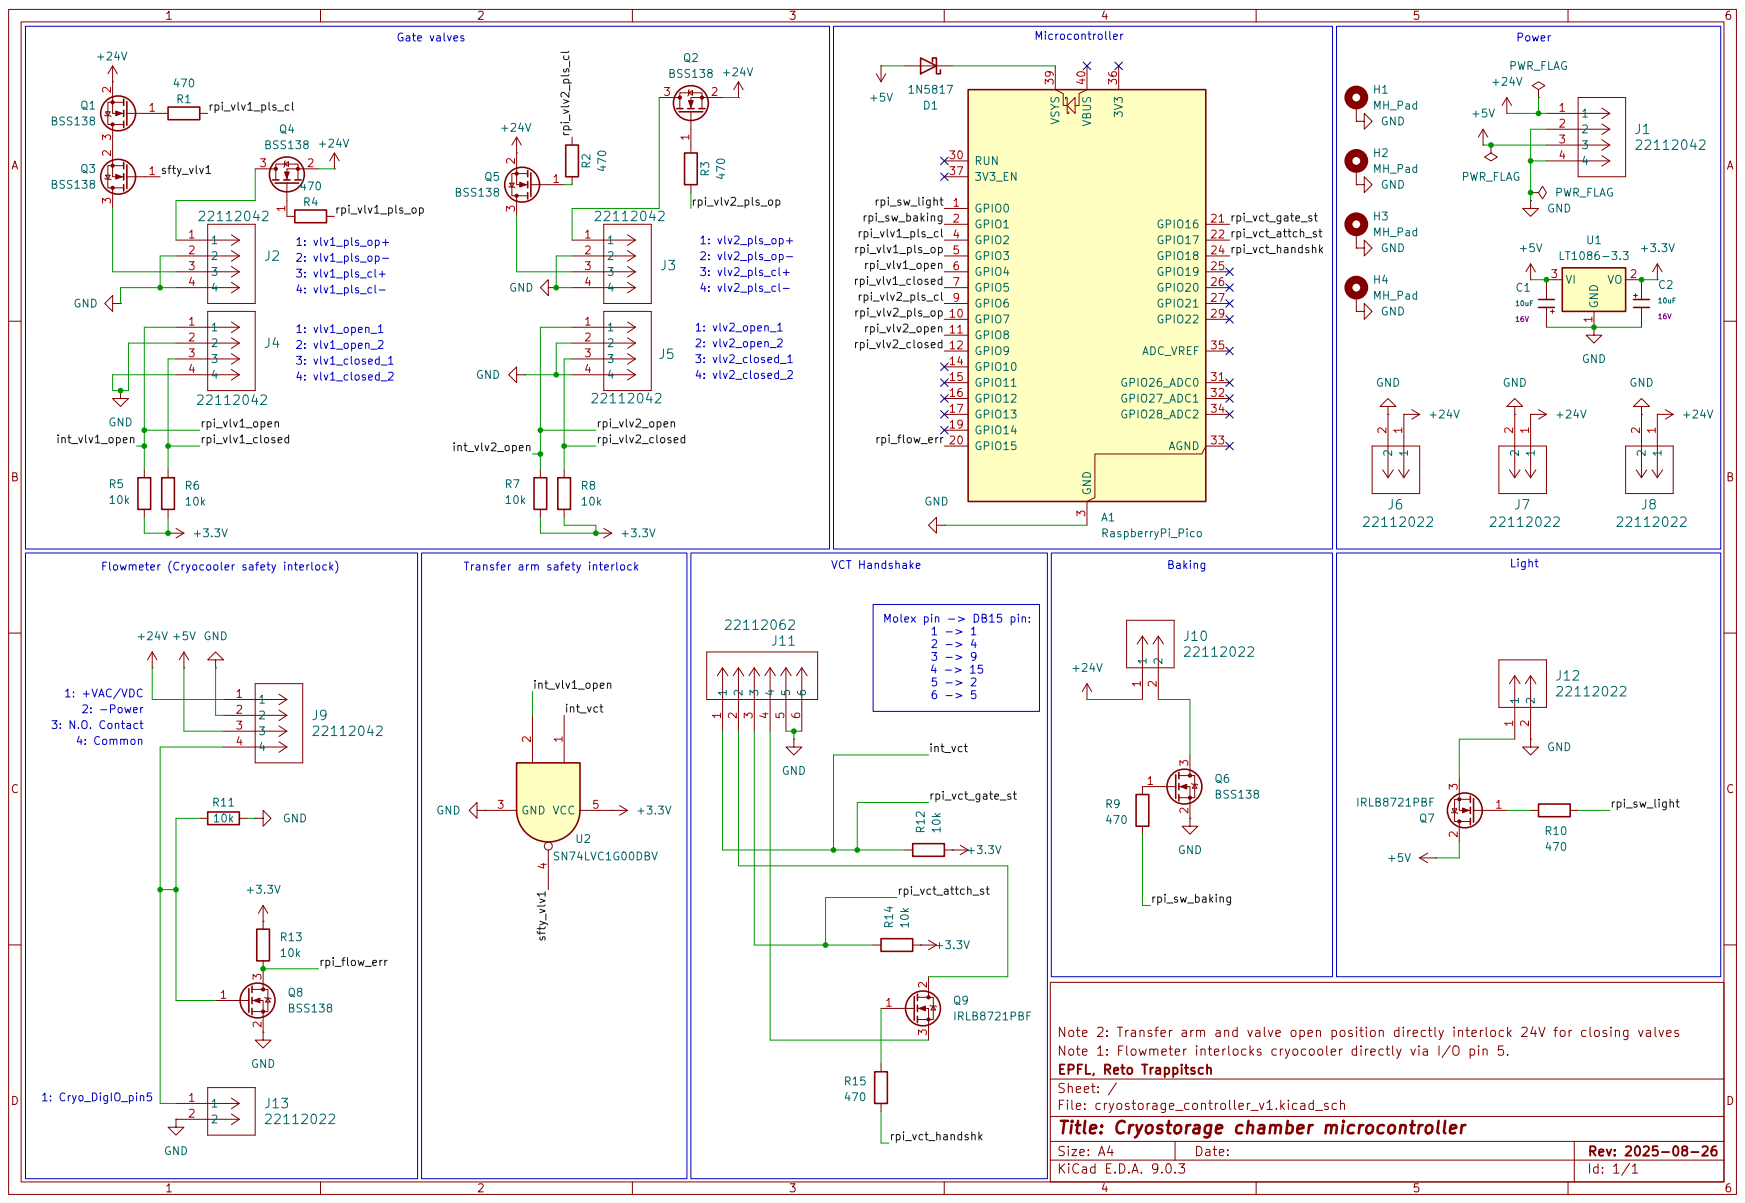
[picture p20: page 1]
