trappitsch/cryostorage/previous_schematics/cryostorage_schematic_2026-07-09.pdf

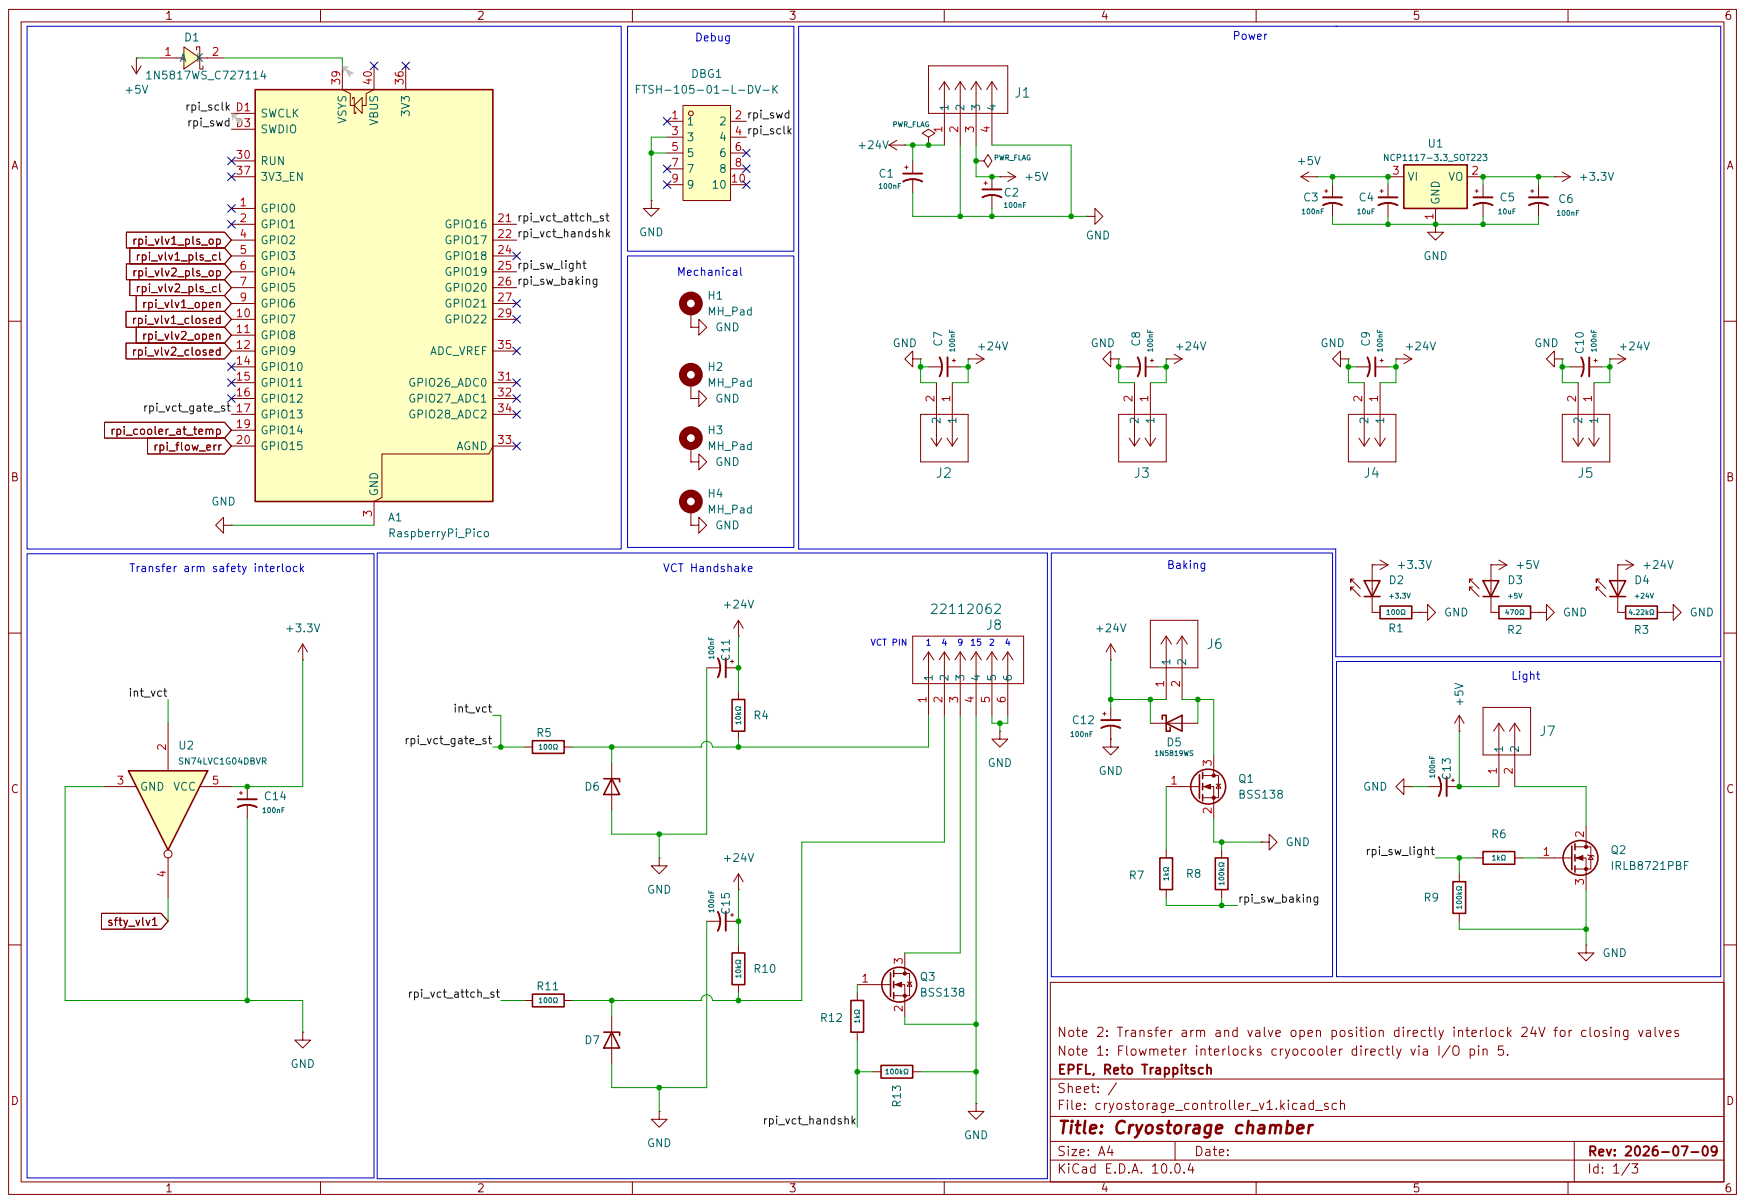
[picture p21: page 1]

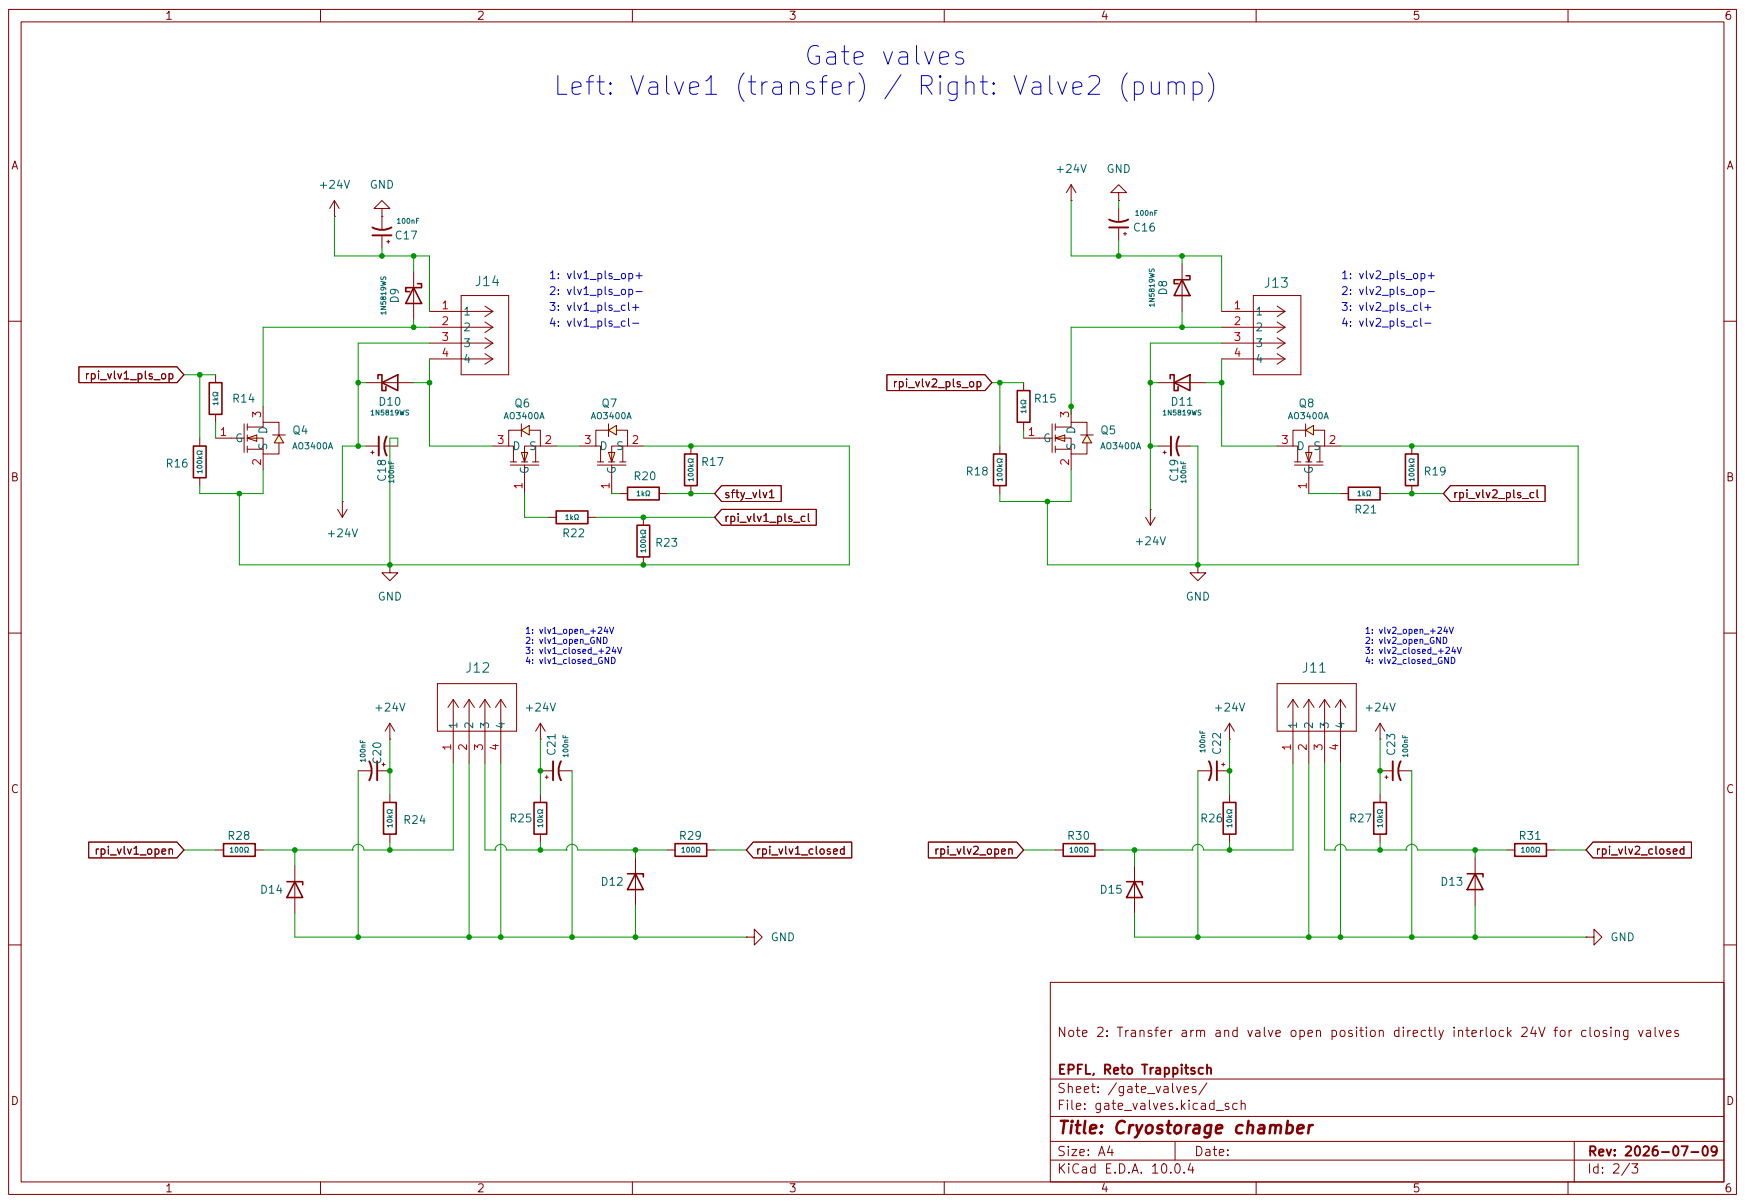
[picture p22: page 2]

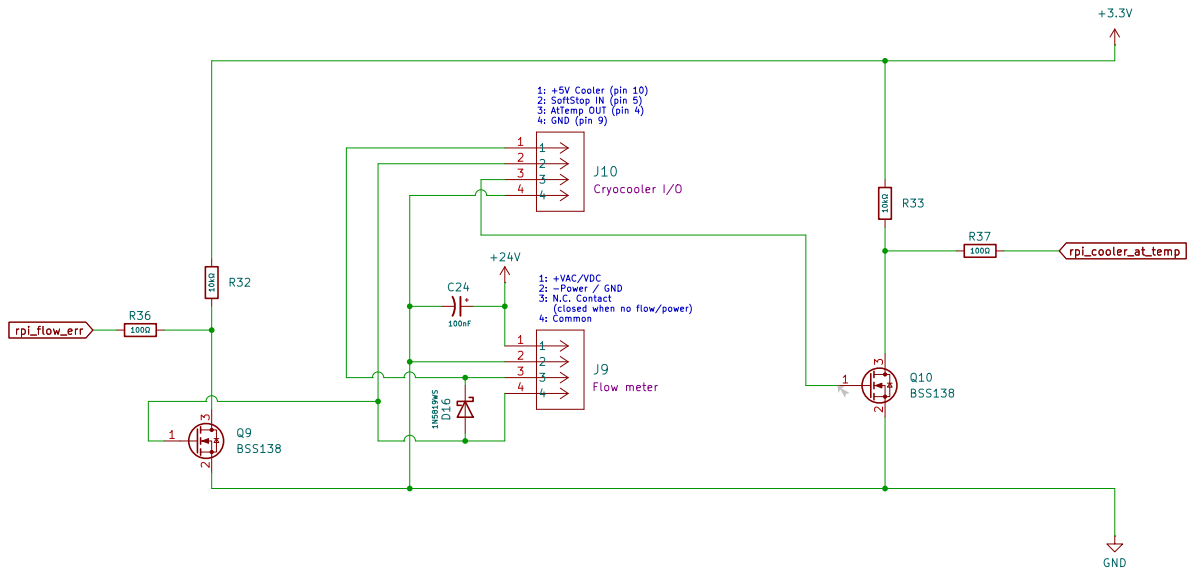
[picture p23: page 3]
