trappitsch/cryostorage/controller/host/src/controller.rs

//! This module handles communication with the controller firmware via poststation.
use std::{
    sync::{
        Arc, Mutex,
        atomic::{AtomicU32, Ordering},
    },
    time::Duration,
};

use icd::{
    BakingState, BcInstStatus, LightState, SetLightEndpoint, SetPumpValveEndpoint,
    SetTransferValveEndpoint, SetVctHandshakeEndpoint, ValveState, VctHandshake, GetUniqueIdEndpoint,
};
use poststation_sdk::{ClientError, PoststationClient};
use serde::{Deserialize, Serialize};
use tokio::{sync::mpsc, time::sleep};

use crate::{
    logger::{LogMessage, send_log_message},
    status::InstrumentStatus,
};

pub enum ControllerCommands {
    Light(LightState),
    Baking(BakingState),
    TransferValve(ValveState),
    PumpValve(ValveState),
    VctHandshake(VctHandshake),
}

/// Task that communicates with the controller firmware via poststation.
pub async fn controller_task(cntrl: Controller, mut rx: mpsc::Receiver<ControllerCommands>) {
    let mut rx_shutdown = crate::HALT_SENDER.get().unwrap().subscribe();

    loop {
        tokio::select! {
            command_result = rx.recv() => {
                if let Some(cmd) = command_result {
                    match cmd {
                        ControllerCommands::Light(state) => {
                            cntrl.light(state).await;
                        }
                        ControllerCommands::Baking(state) => {
                            cntrl.baking(state).await;
                        }
                        ControllerCommands::PumpValve(state) => {
                            cntrl.pump_valve(state).await;
                        }
                        ControllerCommands::TransferValve(state) => {
                            cntrl.transfer_valve(state).await;
                        }
                        ControllerCommands::VctHandshake(handshake) => {
                            cntrl.vct_handshake(handshake).await;
                        }
                    }
                }
            }
            _ = sleep(Duration::from_secs(10)) => {
                // keep alive task, query unique ID every minute to keep stuff alive
                cntrl.keep_alive().await;
            }
            _ = rx_shutdown.recv() => {
                println!("Controller command handling task shutting down");
                break;
            }
        }
    }
}

/// Task that listens to broadcast messages from the controller firmware via poststation.
///
/// This task also updates the UI accordingly.
pub async fn controller_broadcast_listener(
    client: PoststationClient,
    serial: u64,
    inst_status: Arc<Mutex<InstrumentStatus>>,
) {
    let mut rx_shutdown = crate::HALT_SENDER.get().unwrap().subscribe();

    let listener_wait_time = Duration::from_millis(icd::BROADCAST_INTERVAL_MS * 2);

    loop {
        tokio::select! {
            stream_result = client.stream_topic::<BcInstStatus>(serial) => {
                // if let Ok(mut listener) = stream_result {
                match stream_result {
                    Ok(mut listener) => {
                        tokio::select! {
                            msg = listener.recv() => {
                                if let Some(status) = msg {
                                    inst_status.lock().expect("Poisoned").update_from_controller_broadcast(status);
                                } else {
                                    send_log_message(LogMessage::new_error("Poststation broadcast stream closed unexpectedly.")).await;
                                }
                            }
                            _ = sleep(listener_wait_time) => {
                                    send_log_message(LogMessage::new_warning("Poststation listener timed out while waiting for broadcast message.")).await;
                            }
                        }
                    }
                    Err(e) => {
                        if e.to_string().contains("Device Disconnected") {
                            send_log_message(LogMessage::new_error(&format!(
                                "Controller is disconnected: Please check the connection. Retry in {} ms.", icd::BROADCAST_INTERVAL_MS
                            )))
                            .await;
                        } else {
                            send_log_message(LogMessage::new_error(
                                "Connection to poststation lost. Ensure poststation is running and restart this program."
                            )).await;
                            break;
                        }
                        sleep(Duration::from_millis(icd::BROADCAST_INTERVAL_MS)).await;
                    }
                }
            }
            _ = rx_shutdown.recv() => {
                println!("Controller broadcast listener shutting down");
                break;
            }
        }
    }
}

/// Holds the controller communication functions.
pub struct Controller {
    serial: u64,
    client: PoststationClient,
    ctr: AtomicU32,
}

impl Controller {
    pub fn new(client: PoststationClient, serial: u64) -> Self {
        Self {
            client,
            serial,
            ctr: AtomicU32::new(0),
        }
    }

    #[inline(always)]
    fn ctr(&self) -> u32 {
        self.ctr.fetch_add(1, Ordering::Relaxed)
    }

    pub async fn keep_alive(&self) {
        if self
            .client
            .proxy_endpoint::<GetUniqueIdEndpoint>(self.serial, self.ctr(), &())
            .await
            .is_err()
        {
            send_log_message(LogMessage::new_error(
                "Failed to send keep-alive to controller",
            ))
            .await;
        }
    }

    pub async fn baking(&self, baking_state: BakingState) {
        if self
            .client
            .proxy_endpoint::<icd::SetBakingEndpoint>(self.serial, self.ctr(), &baking_state)
            .await
            .is_err()
        {
            send_log_message(LogMessage::new_error(
                "Failed to send new baking state to controller",
            ))
            .await;
        }
    }

    pub async fn light(&self, light_state: LightState) {
        if self
            .client
            .proxy_endpoint::<SetLightEndpoint>(self.serial, self.ctr(), &light_state)
            .await
            .is_err()
        {
            send_log_message(LogMessage::new_error(
                "Failed to send new light state to controller",
            ))
            .await;
        }
    }

    pub async fn pump_valve(&self, valve_state: ValveState) {
        if self
            .client
            .proxy_endpoint::<SetPumpValveEndpoint>(self.serial, self.ctr(), &valve_state)
            .await
            .is_err()
        {
            send_log_message(LogMessage::new_error(
                "Failed to send new pump valve state to controller",
            ))
            .await;
        }
    }

    pub async fn transfer_valve(&self, valve_state: ValveState) {
        if self
            .client
            .proxy_endpoint::<SetTransferValveEndpoint>(self.serial, self.ctr(), &valve_state)
            .await
            .is_err()
        {
            send_log_message(LogMessage::new_error(
                "Failed to send new transfer valve state to controller",
            ))
            .await;
        }
    }

    pub async fn vct_handshake(&self, handshake: VctHandshake) {
        if self
            .client
            .proxy_endpoint::<SetVctHandshakeEndpoint>(self.serial, self.ctr(), &handshake)
            .await
            .is_err()
        {
            send_log_message(LogMessage::new_error(
                "Failed to send new VCT handshake to controller",
            ))
            .await;
        }
    }
}

/// Get a clone of the controller command sender.
fn get_cntrl_cmd_sender() -> mpsc::Sender<ControllerCommands> {
    crate::CONTROLLER_COMMAND_SENDER
        .get()
        .expect("Uninitialized")
        .clone()
}

/// Convenience function to await sending a controller command.
///
/// If an error occurs, this error is printed to stderr. Otherwise, the program will continue
/// as normal.
pub async fn send_cntrl_cmd(cmd: ControllerCommands) {
    let sender = get_cntrl_cmd_sender();
    if let Err(e) = sender.send(cmd).await {
        eprintln!("Could not send controller command: {}", e);
    }
}

/// Convenience function to send a controller command without awaiting.
///
/// If an error occurs, this error is printed to stderr. Otherwise, the program will continue
/// as normal.
pub fn send_cntrl_cmd_now(cmd: ControllerCommands) {
    let sender = get_cntrl_cmd_sender();
    if let Err(e) = sender.try_send(cmd) {
        eprintln!("Could not send controller command now: {}", e);
    }
}

/// A structure that holds the configuration for the controller.
#[derive(Debug, Clone, Serialize, Deserialize)]
pub struct ControllerConfig {
    /// The serial number of the controller -> get form poststation.
    pub serial: u64,
    /// Address and port of the poststation serve.
    pub address: String,
}

impl Default for ControllerConfig {
    fn default() -> Self {
        Self {
            serial: 123456789,
            address: String::from("127.0.0.1:51837"),
        }
    }
}
