trappitsch/cryostorage/(commit log)

2025-07-07 add a first draft of slint ui
    [cryostorage_controller_v1.kicad_pcb, cryostorage_controller_v1.kicad_sch]
2025-07-09 fix small switch visibility
2025-08-25 update schematic and add first PCB final version
    [BOM-cryostorage_controller_v1.csv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]
2025-08-26 clean up git, finish PCB for first order, v2025-08-26
    [BOM-cryostorage_controller_v1.csv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]
2025-09-03 fix C1 problem and replace voltage regulator
    [cryostorage_controller_v1.kicad_pcb, cryostorage_controller_v1.kicad_sch]
2025-09-05 enhance board and fix v1 issues
    [BOM-cryostorage_controller_v1.csv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]
2025-09-15 pcb for controller v2025-09-12
    [BOM-cryostorage_controller_v1.csv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]
2025-09-24 fix errors in pcb for next version (needs double checking)
    [BOM-cryostorage_controller_v1.csv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]
2025-09-24 next firmware version with 2025-09-12 board
    to be tested when fixed board is ready
    [lib.rs, main.rs, vct.rs]
2025-09-24 add sample container and permanent config storage using RON
2025-09-25 program configuration and saving, sample management
2025-09-28 changed sample input to my own keyboard implementation, add keypad -> admin mode
2025-09-30 add broadcast update for baking and waterflow, add status of device
2026-01-28 add a async crate for the HiCube pump controller with example
2026-01-28 changes while testing firmware with instrument for the first time
    [cryostorage_controller_v1.kicad_sch]
2026-01-28 hook up valves to controller and vct handshake (testbutton)
2026-01-29 fix broadcast receiving when unplugging, replugging
    - refractor broadcast interval into `icd`
    - change firmware to use updated broadcast interval
    [controller.rs, lib.rs, main.rs]
2026-01-29 fix sample name not stored after change
    [app.rs, samples.rs]
2026-02-06 fix valve status display (colors), update status on initialization
    [app.rs, mod.rs, valve.rs]
2026-02-06 first integration of instruments: add temperature reading of lakeshore336
2026-02-06 add cryocooler instrument and read temperature
2026-02-06 allow setting setpoint temperature from GUI
2026-02-06 increase valve pulse time to 500ms
2026-02-06 change broadcast tokio_select statements. hopefully fixes streaming issue
    [mod.rs]
2026-02-06 agilent ion pump state and control implemented
2026-02-06 change vacuum pump and transfer system position in drawing
2026-02-06 Fix pump stand state. now indicates on/off/spinning up/down
    [app.rs, pump_commands.rs]
2026-02-06 turn pump stand off by setting the correct status
2026-02-09 change defaults for temperature sensor to represent today's wiring
2026-02-16 revise control board schematic (pcb not yet updated)
    [cryocooler_safety.kicad_sch, cryostorage_controller_v1.kicad_pcb, cryostorage_controller_v1.kicad_sch, gate_valves.kicad_sch]
2026-02-16 add omnicontrol temporary driver
2026-02-17 first properly displaying temperature and pressure figures
2026-02-19 allow running with no device connected, remove broadcast timeout checker (not needed)
2026-02-19 clean up host crate and fix most lints
    [app.rs, connections.rs, main.rs, mod.rs]
2026-02-19 only plot/save temperatures if at least one is non-zero
2026-02-19 add and enable workflows to open/close valves
2026-02-19 add +d button for baking
2026-02-26 put in a timeout for connecting to the HiCube and error if it fails
    [lib.rs]
2026-02-26 switch vct checking status in valve close permission to `is_gate_attached`
2026-02-26 turn vct green when attached
2026-02-26 pcb version 2025-02-25 finished
    [BOM-cryostorage_controller_v1.csv, cryocooler_safety.kicad_sch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]
2026-03-10 wait for poststation to start (if not started) and if all fails, give proper error message
    [mod.rs]
2026-03-10 add build version capability and use switch drive for distribution
2026-03-12 add a re-terminal scripts folder with an update via switchdrive file version
2026-03-12 autoscale temperature plot according to values (30K total range)
2026-03-12 cleanup println and testing statements/functions
2026-05-04 Store date a sample is loaded along with sample name and display it
2026-05-04 Add swipe and swap funcitonality for moving samples between positions
    [app.rs, prg_config.rs, samples.rs]
2026-07-17 pcb v2026-07-10
2026-07-17 add light button to workflows. NEED FW UPDATE
2026-11-11 update firmware for pcb v2026-07-10, reactivate water flow checking
2026-11-12 update book with safety features of latest version
    - update the cryocooler safety features to the latest electronics
    - remove the warning in the workflows as this will remove it
    - update kicad schematic to prettify the snippet we need for docs
2026-11-12 FW: Change signals to channels where we don't want to loose commands.
    Valve open/close and get_state commands are currently done with signals,
    but should really be channels. Also checked for other signals:
    In the end, the following signals were replaced with channels:
    - PUMP_VALVE_SIGNAL -> PUMP_VALVE_CHANNEL
    - TRANSFER_VALVE_SIGNAL -> TRANSFER_VALVE_CHANNEL
    - VCT_SIGNAL
    - BAKING_SIGNAL
2026-11-12 Run heater task always
    Start the heater task at system startup.
    This way, it wil work if
    - cryocooler is already running
    - shutdown and startup issue of spawning that task is gone
    It's a task every 5 secodns, it won't eat that much hay ;)
2026-11-13 HOST: deactivate flow check
2026-11-13 FIX: Heater does not start when starting cryo cooler
